sean-mackenzie/billie-bot-claude/billiebot_ws/src/billiebot_sensor_tests/firmware/README.md

The Sensor Nano firmware (sensor_nano.ino) and documentation has been moved to: billie-bot-claude/firmware/sensor_nano
