sean-mackenzie/billie-bot-claude/docs/md/BRINGUP_LADDER_ANALYSIS.md

# BillieBot Bringup Ladder — Systems Decomposition & Analysis

**Author role:** Senior Systems Engineer decomposition
**Sources:** `docs/VERIFICATION.md`, all launch files, node sources, configuration files, interface definitions, and `BillieBot_System_Design.md` (source document of `BillieBot_System_Design.md.pdf`).
**Originally written:** 2026-07-03 (by static analysis only — no code was executed to produce the first revision)
**Last reviewed:** 2026-07-28

> **This is a living document, not a historical snapshot.** Appendix B is the register of record for
> bringup-ladder defects; entries are struck through and marked resolved as they close, and the
> per-rung sections are corrected alongside them so no section describes behavior the code no longer
> has. When you close an item here, also update `DISCREPANCY_RESOLUTION_PLAN.md` (§2 table + sheet)
> and `MBSE_SYSTEM_DECOMPOSITION.md` (§5.4 register) in the same PR.

### Revision log

| Date | Change |
|---|---|
| 2026-07-03 | Initial decomposition of rungs 01–14; Appendix B raised B-1…B-20 |
| 2026-07-17 | B-3, B-4, B-8 resolved (GAP-5, GAP-6, GAP-4) |
| 2026-07-28 | B-9 resolved (GAP-20, lidar by-id path) |
| 2026-07-28 | B-1, B-2 resolved (GAP-16 — `mock_scan` node) and B-13 resolved (tf2 registration import); B-6 resolved (GAP-21 — documented bundled map). Rung 01/05/06/14 sections corrected to match; verified by running the mock ladder rather than by re-reading source |

---

## 1. Purpose & Method

This report decomposes each of the 14 rungs of the Bringup Ladder defined in `docs/VERIFICATION.md`. For each rung it answers:

1. **Referenced files** — launch files (including transitive includes), configs, node sources, verify scripts, and external package dependencies.
2. **Key input parameters** — the parameters that materially determine behavior, with values and rationale.
3. **Runtime process architecture** — which nodes run, what each publishes/subscribes/serves, message types, publish rates, TF contributions, and mock-vs-real differences.
4. **Measurable outputs** — the concrete data and physical observables that verify correct function, with the exact commands to measure them.
5. **Requirements traceability** — which `SYS-*` requirements from the System Design Document the rung satisfies (fully, partially, or could with additions), cross-referenced to the TC-01…TC-22 acceptance-test IDs.

Method: every claim below is traced to a file in this repository. Facts that come from hardware datasheets or upstream package behavior rather than this repo (e.g., RPLidar A1 scan rate, Nav2 default action names) are marked *(inference)*.

### 1.1 System context

BillieBot is a differential-drive indoor robot whose MVP mission is **observe-and-report**: patrol an apartment, find a miniature dachshund (Billie), hold a ≥1.0 m standoff, fuse visual/thermal/audio evidence into a behavioral state, log state transitions to SQLite, and serve a daily HTTP report. The software is a ROS 2 (Humble-targeted) stack split across three processors:

| Host | Role | Nodes (per design §5.2 and the `jetson.launch.py`/`pi.launch.py` split) |
|---|---|---|
| **Jetson Orin Nano** | Real-time autonomy | `rplidar_node`, `base_bridge`, `ekf_filter_node`, `slam_toolbox`/`amcl`, Nav2 stack, `oakd_dog_detector`, `dog_locator`, mission nodes |
| **Raspberry Pi 5** | Sensing & cognition | `thermal_node`, `noir_cam_node`, `audio_classifier`, `speaker_node`, `state_fusion`, `dog_logger`, `daily_report`, `report_server` |
| **Arduino Nano** | Hard real-time I/O | Encoder counting, PID @30 Hz, L298N PWM, battery ADC, 500 ms serial-heartbeat motor cutoff (`firmware/README.md`) |

Multi-machine DDS uses CycloneDDS with multicast disabled and static unicast peers (`billiebot_bringup/config/cyclonedds.xml`: Jetson `192.168.42.100`, Pi `192.168.42.101`). The `jetson.launch.py` and `pi.launch.py` files set `CYCLONEDDS_URI` to this config and launch the host-appropriate subset of rungs — they are deployment groupings, not rungs themselves.

Every rung (except 08 and 12) accepts a `mock:=true` launch argument that substitutes hardware drivers with synthetic publishers so the entire ladder can be exercised on a development machine.

### 1.2 Launch inclusion graph

Rungs compose **transitively** — launching rung N brings up (most of) the rungs below it. Several integration defects identified in Appendix B arise directly from double-inclusion in this graph.

```
14_full_bringup ─┬─► 06_nav2 ─┬─► 05_amcl ─┬─► 01_lidar                (rplidar OR mock_scan)
                 │            │            ├─► 03_ekf ──► 02_base ─┬─► description.launch.py (robot_state_publisher)
                 │            │            │        │              └─► base.launch.py (base_bridge)
                 │            │            │        └─► ekf_node (robot_localization)
                 │            │            └─► localization.launch.py (map_server + amcl + lifecycle_mgr)
                 │            └─► navigation.launch.py (controller + planner
                 │                                       + behaviors + bt_navigator + lifecycle_mgr)
                 ├─► 07_oakd            (oakd_dog_detector)
                 ├─► 08_dog_locator     (dog_locator)
                 ├─► 09_thermal         (thermal_node)
                 ├─► 10_noir            (noir_cam_node)
                 ├─► 11_audio ──► audio.launch.py (audio_classifier + speaker_node)
                 ├─► 12_cognition ──► cognition.launch.py (state_fusion + dog_logger
                 │                                          + daily_report + report_server)
                 └─► 13_mission ──► mission.launch.py (mission_controller + approach_dog_server
                                                        + retreat_server + speak_server
                                                        + dispense_treat_server)

04_slam ─┬─► 01_lidar
         ├─► 03_ekf ──► 02_base ──► (as above)
         └─► slam.launch.py (async_slam_toolbox_node)      [04 is NOT included by 05/06/14 —
                                                             mapping and localization are alternatives]
```

Two duplications that this graph used to expose are now closed: in mock mode `01_lidar` once launched a **second `base_bridge` instance** (named `mock_lidar_stub`) alongside the `03→02` chain — resolved 2026-07-28 (GAP-16), the mock branch now launches the dedicated `mock_scan` node — and rung 06 once started two `ekf_filter_node`s via `navigation.launch.py` — resolved 2026-07-17 (GAP-6). See Appendix B.

### 1.3 Per-rung template

Each rung section below follows the five-question structure: **(1) Referenced files → (2) Key parameters → (3) Runtime architecture → (4) Measurable outputs → (5) Requirements traceability.** All paths are relative to `billiebot_ws/src/` unless otherwise noted.

---

## 2. Rung 01 — Lidar

```bash
ros2 launch billiebot_bringup 01_lidar.launch.py mock:=true
```

### 2.1 Referenced files

| File | Role |
|---|---|
| `billiebot_bringup/launch/01_lidar.launch.py` | Rung entry point; selects real vs. mock via `IfCondition`/`UnlessCondition` |
| `billiebot_base/billiebot_base/mock_scan.py` | **Mock branch only** — synthetic `/scan` publisher (see §2.3) |
| `billiebot_bringup/config/lidar.yaml` | **Real branch only** — serial by-id path, baud, scan mode (GAP-20) |
| `billiebot_bringup/scripts/verify_rung_01.sh` | Verification script (topic existence + `ros2 topic hz`) |
| External: `rplidar_ros` package (`rplidar_node`) | Real lidar driver *(external dependency)* |

### 2.2 Key input parameters

| Parameter | Value | Significance |
|---|---|---|
| `mock` (launch arg) | default `false` | Selects driver vs. placeholder stub |
| `serial_port` | `/dev/serial/by-id/usb-Silicon_Labs_CP2102_..._0001-if00-port0` | RPLidar A1 USB-UART device on the Jetson. Stable by-id path, matching the `base_bridge` convention — plug-in order and `ttyUSBn` numbering are irrelevant (Appendix B-9, GAP-20). Set in `billiebot_bringup/config/lidar.yaml`, not inline in the launch file |
| `serial_baudrate` | `115200` | A1 standard baud |
| `frame_id` | `laser_frame` | Must match the link created by `billiebot_description/urdf/lidar.xacro` (it does) |
| `angle_compensate` | `true` | Interpolates to uniform angular spacing for SLAM |
| `scan_mode` | `Standard` | A1 standard mode: ~8 kHz sample rate, ~5.5 Hz rotation *(datasheet inference)* |

### 2.3 Runtime process architecture

**Real mode** — one node:

| Node | Pub | Type | Rate |
|---|---|---|---|
| `rplidar_node` | `/scan` | `sensor_msgs/LaserScan` | ~5.5–8 Hz *(A1 hardware inference)* |

No TF is produced by this rung. `/scan` messages carry `frame_id: laser_frame`, which is **unresolvable** until rung 02 brings up `robot_state_publisher` (the `chassis → laser_frame` static transform lives in the URDF). Standalone RViz viewing requires setting the fixed frame to `laser_frame`.

**Mock mode** — one node, a purpose-built synthetic lidar (**resolved 2026-07-28, GAP-16**; this rung was previously the ladder's most significant defect):

The mock branch launches `billiebot_base`'s `mock_scan` executable, which publishes a synthetic `LaserScan` describing a rectangular room (`NUM_SAMPLES = 360`, `ROOM_HALF_X = 2.5 m`, `ROOM_HALF_Y = 2.0 m`, with per-beam noise). It replaced a `base_bridge` instance named `mock_lidar_stub` that published no `/scan` at all — the origin of Appendix B-1 and B-2.

| Node | Pub | Type | Rate |
|---|---|---|---|
| `mock_scan` | `/scan` | `sensor_msgs/LaserScan` | 10 Hz, `frame_id: laser_frame` |

Consequences of the fix: the rung's own verify criterion passes in mock, higher rungs no longer gain a duplicate `base_bridge`, and mock SLAM/AMCL/costmaps receive real scan data. Measured 2026-07-28 in the `billiebot-dev` container: `/scan` at **10.008 Hz**, `verify_rung_01.sh` **`[PASS]` ×2**, `ros2 node list` shows `/mock_scan` alone.

### 2.4 Measurable outputs

| Output | Measurement | Expected (real) | Expected (mock) |
|---|---|---|---|
| `/scan` exists & publishes | `ros2 topic echo /scan --once`; `ros2 topic hz /scan` | LaserScan at ~5.5–8 Hz, 360° ranges 0.15–12 m | LaserScan at 10 Hz (observed 10.008 Hz) |
| Scan geometry sane | RViz LaserScan display, fixed frame `laser_frame` | Room outline visible; motor audibly spinning (physical) | Synthetic 5.0 × 4.0 m rectangle |
| Script result | `./scripts/verify_rung_01.sh` | `[PASS]` ×2, exit 0 | `[PASS]` ×2, exit 0 |

The verify script checks topic existence via `ros2 topic info` and then rate via `timeout 5 ros2 topic hz` — it validates *liveness*, not scan content or field ranges.

### 2.5 Requirements traceability

| Requirement | Relationship |
|---|---|
| **SYS-NAV-1** (lidar SLAM map) | **Prerequisite.** `/scan` is the sole input to `slam_toolbox` (rung 04) and AMCL (rung 05). Rung 01 alone doesn't satisfy it, but SYS-NAV-1 is unreachable without it. |
| **SYS-NAV-2, SYS-NAV-3** | Prerequisite — `/scan` drives AMCL localization and both Nav2 costmap obstacle layers (`nav2_params.yaml` `observation_sources: scan`). |
| Design §3.4 BDD-03 | The lidar is modeled under the Perception Subsystem with data allocated to Nav — rung 01 verifies the physical `lidar → jet` USB/UART item flow of IBD-01. |
| TC coverage | No dedicated TC; TC-02…TC-06 begin at rung 02. Now satisfies a lidar-liveness test in mock as well as real, since `mock_scan` publishes a genuine `/scan` (Appendix B-1, resolved) — the proposed TC-23 can be scripted against either mode. |

---

## 3. Rung 02 — Base + Description

```bash
ros2 launch billiebot_bringup 02_base.launch.py mock:=true
```

### 3.1 Referenced files

| File | Role |
|---|---|
| `billiebot_bringup/launch/02_base.launch.py` | Rung entry; includes the two package launches below |
| `billiebot_description/launch/description.launch.py` | Runs `xacro` on the URDF and starts `robot_state_publisher` |
| `billiebot_description/urdf/billiebot.urdf.xacro` | Top-level robot model; includes `robot_core.xacro`, `lidar.xacro`, `oakd_lite.xacro`, `noir_camera.xacro`, `thermal.xacro`, `mic_array.xacro`, `imu.xacro`, `inertial_macros.xacro` |
| `billiebot_base/launch/base.launch.py` | Starts `base_bridge` with the config below |
| `billiebot_base/config/base_driver.yaml` | All drive/serial/battery parameters |
| `billiebot_base/billiebot_base/base_bridge.py` | Differential-drive bridge node (480 lines; contains `MockSerial`) |
| `billiebot_interfaces/srv/EStop.srv` | E-stop service definition |
| `billiebot_bringup/scripts/verify_rung_02.sh` | Verification script |
| `docs/MEASURE_ME.md` | Documents which of these parameters are placeholders pending physical measurement |
| Related (not launched): `reference_my_bot/diff-drive-motor-controller/` and `firmware/README.md` | The Arduino-side serial protocol implementation and the 500 ms watchdog change |

### 3.2 Key input parameters

From `base_driver.yaml` (calibration status per `docs/MEASURE_ME.md`):

| Parameter | Value | Significance |
|---|---|---|
| `port` / `baudrate` | `/dev/serial/by-id/usb-1a86_USB_Serial-if00-port0` @ 57600 | Stable-path Arduino serial link (CH340 adapter) |
| `wheel_radius` | 0.034 m | Odometry scale — **to be measured under load** |
| `wheel_separation` | 0.298 m | Yaw-rate scale — **to be measured** |
| `encoder_ticks_per_rev` | 2000.0 | Tick→radian conversion; reference project offers 1974.7/1779.0 alternatives — **calibrate by driving 1 m** |
| `pid_rate_hz` | 30.0 | Must match Arduino PID loop rate; used in the counts-per-loop conversion |
| `cmd_timeout_sec` | 0.5 | Software deadman: zero motor command if no `/cmd_vel` for 0.5 s (complements the Arduino 500 ms heartbeat cutoff) |
| `publish_rate_hz` | 30.0 | Rate of the odom/joint/TF pipeline |
| `publish_tf` | `false` | EKF owns `odom → base_link` from rung 03 up (GAP-5 resolved 2026-07-17); rung-02-only bench work can restore the base broadcast with the `publish_tf:=true` launch arg (Appendix B-3) |
| `use_imu` | `false` | BNO055 disabled until the A4/A5 encoder rewire (`docs/MEASURE_ME.md`) |
| `battery_divider_ratio` / `battery_pin` | 6.0 / A0 | ADC→voltage: `V = adc·5/1023·6.0` |
| `battery_low_voltage` / `battery_critical_voltage` | 10.5 V / 9.9 V | 3.5 and 3.3 V/cell thresholds (SYS-PLT-2 boundary values) |
| `left/right_motor_sign`, `*_encoder_sign` | 1.0 | Polarity flips set during physical commissioning |
| Description args | `use_lidar/oakd/noir/thermal/mic:=true`, `use_imu:=false` | Gate which sensor links appear in the URDF/TF tree |

### 3.3 Runtime process architecture

Two nodes:

**`robot_state_publisher`** — runs `xacro billiebot.urdf.xacro` at launch time via a `Command` substitution:

| Interface | Direction | Type | Rate |
|---|---|---|---|
| `/robot_description` | pub (latched/transient-local) | `std_msgs/String` | once |
| `/tf_static` | pub | `tf2_msgs/TFMessage` | once — all fixed joints: `base_link→chassis`, `chassis→laser_frame`, `chassis→oakd_link→oakd_link_optical`, `chassis→noir_link→noir_link_optical`, `chassis→thermal_link→thermal_link_optical`, `chassis→mic_array` (names from the xacro files; positions are `TODO(measure)` placeholders) |
| `/joint_states` | sub | `sensor_msgs/JointState` | consumes base_bridge output to publish wheel-joint TF on `/tf` at 30 Hz |

**`base_bridge`** — the drive interface. Internal loop (`update()` on a 30 Hz timer): apply e-stop/timeout gating → send `m <left_cpl> <right_cpl>` motor command over serial → read encoders with `e` → integrate differential-drive odometry (exact midpoint-arc model) → publish. Conversion: `counts_per_loop = rad_s/(2π) · 2000 / 30`.

| Interface | Direction | Type | Rate / trigger |
|---|---|---|---|
| `/cmd_vel` | sub | `geometry_msgs/Twist` | inverse kinematics: `v ± ω·d/2 / r` → wheel targets; ignored while e-stopped |
| `/odom` | pub | `nav_msgs/Odometry` (`odom`→`base_link`, pose + twist) | 30 Hz |
| `/joint_states` | pub | `sensor_msgs/JointState` (`left_wheel_joint`, `right_wheel_joint` pos+vel) | 30 Hz |
| `/battery_state` | pub | `sensor_msgs/BatteryState` (voltage, per-cell array, health enum vs. 10.5/9.9 V thresholds) | 1 Hz |
| TF `odom → base_link` | broadcast | `TransformStamped` | 30 Hz (gated by `publish_tf`) |
| `/e_stop` | service server | `billiebot_interfaces/srv/EStop` (`engage: bool → success, message`) | engage: zeroes targets, sends `m 0 0`, blocks `/cmd_vel`; release: re-enables |

**Serial protocol** (Jetson ↔ Arduino, 57600 baud, `\r`-terminated — mirrors `reference_my_bot` ROSArduinoBridge):

| Cmd | Meaning | Response |
|---|---|---|
| `m L R` | Target wheel speeds in encoder counts/PID-loop | `OK` |
| `e` | Read cumulative encoder ticks | `<left> <right>` |
| `r` | Reset encoders | `OK` |
| `a <pin>` | Read ADC (battery divider) | `0–1023` |

**Mock vs. real:** `MockSerial` replaces `pyserial` in-process. It integrates commanded counts-per-loop into fake encoder ticks (perfect compliance — commanded velocity is instantly achieved) and answers `a` with a constant ADC of 429 → **12.58 V** battery forever. Consequence: battery-triggered SAFE-mode logic (rung 13) can never fire in mock mode.

TF tree after this rung (matches VERIFICATION.md): `odom → base_link → chassis → {laser_frame, oakd_link[_optical], noir_link[_optical], thermal_link[_optical], mic_array}` plus wheel joints.

### 3.4 Measurable outputs

| Output | Measurement | Expected |
|---|---|---|
| Odometry | `ros2 topic hz /odom` → 30 Hz; `ros2 topic echo /odom` | Pose integrates when commanded; twist echoes commanded velocity (mock: exactly) |
| Joint states | `ros2 topic hz /joint_states` → 30 Hz | Wheel positions monotonically increase while driving |
| Battery | `ros2 topic echo /battery_state` | Mock: 12.58 V, health `GOOD`; real: pack voltage within 9.9–12.6 V |
| TF | `ros2 run tf2_tools view_frames` | Single connected tree `odom→base_link→chassis→sensors` |
| Robot description | `ros2 topic echo /robot_description --once` | Valid URDF XML (TC-02) |
| E-stop | `ros2 service call /e_stop billiebot_interfaces/srv/EStop "{engage: true}"` | `success: true`; subsequent `/cmd_vel` produces zero motion / zero odom delta |
| **Physical (real)** | `ros2 topic pub /cmd_vel geometry_msgs/msg/Twist "{linear: {x: 0.1}}"` | Robot drives forward ~0.1 m/s (wrong direction ⇒ flip `*_sign` params per MEASURE_ME); odom `x` grows ≈ tape-measure distance |
| Closed-loop odometry sanity | Drive 1.0 m, compare `/odom` | Error budget informs `encoder_ticks_per_rev` calibration |
| Script | `./scripts/verify_rung_02.sh` | 6/6 PASS (4 topics + `/tf` + `/e_stop`), exit 0 |

### 3.5 Requirements traceability

| Requirement / TC | Relationship |
|---|---|
| **TC-02** (URDF validity → SYS-NAV-1) | **Satisfied** — `/robot_description` published from the xacro chain |
| **TC-03** (Odometry → SYS-NAV-2) | **Satisfied (mechanism)** — `/odom` at 30 Hz. The ≤0.15 m accuracy figure of SYS-NAV-2 belongs to rung 05 + a physical test |
| **TC-04** (Joint states) | **Satisfied** |
| **TC-05** (Battery monitoring → SYS-PLT-2) | **Partial** — voltage measurement, per-cell reporting, and threshold-based health enums exist. The *reaction* (enter SAFE, stop, alert) lives in rung 13's mission controller; "request pickup"/alert is unimplemented |
| **TC-06** (E-stop service → SYS-PLT-5) | **Partial** — the software e-stop path exists and stops motor commands. The **200 ms PWM-cut latency** and the **Arduino-side 500 ms heartbeat watchdog** are firmware properties (`firmware/README.md`, `AUTO_STOP_INTERVAL 500`) verifiable only on hardware with a timing rig — not by this rung's script |
| **SYS-PLT-4** (teleop) | **Enabler** — `/cmd_vel` + `/e_stop` are exactly the teleop surface; no teleop node is launched by any rung |
| **SYS-EXT-4 note** | `base_bridge` odometry feeds the EKF that the future engagement-outcome measurement ("dog approaches robot") will rely on |

---

## 4. Rung 03 — EKF

```bash
ros2 launch billiebot_bringup 03_ekf.launch.py mock:=true
```

### 4.1 Referenced files

| File | Role |
|---|---|
| `billiebot_bringup/launch/03_ekf.launch.py` | Rung entry; includes **rung 02 in its entirety**, then adds the EKF |
| `billiebot_navigation/config/ekf.yaml` | `robot_localization` configuration |
| All rung-02 files | Transitively included |
| External: `robot_localization` (`ekf_node`) | The filter implementation *(external dependency)* |

Note the rung's docstring says "EKF on top of base **+ lidar**", but the launch file includes only `02_base.launch.py` — no lidar. Correct behavior (the EKF doesn't consume `/scan`), stale comment.

### 4.2 Key input parameters

From `ekf.yaml`:

| Parameter | Value | Significance |
|---|---|---|
| `frequency` | 30.0 | Filter output rate, matched to base_bridge's 30 Hz input |
| `two_d_mode` | `true` | Planar robot: z/roll/pitch forced to zero |
| `publish_tf` | `true` | EKF broadcasts `odom → base_link` — sole owner since GAP-5 resolution (base_bridge default is now `false`; Appendix B-3) |
| `odom_frame`/`base_link_frame`/`world_frame` | `odom`/`base_link`/`odom` | Odom-frame filter (map frame left to SLAM/AMCL) |
| `odom0` | `/odom` | Sole active sensor input |
| `odom0_config` | fuses x, y, yaw, vx, vy, vyaw | Absolute pose + planar velocities from wheel odometry |
| `imu0` (commented out) | `/imu/data` | Entire IMU block disabled pending the BNO055 A4/A5 rewire — with a single sensor the "fusion" is effectively a smoother, not a multi-sensor EKF |
| `process_noise_covariance` | 15×15 diag | Standard robot_localization defaults, lightly tuned |

### 4.3 Runtime process architecture

Everything from rung 02, plus:

| Node | Interface | Direction | Type | Rate |
|---|---|---|---|---|
| `ekf_filter_node` | `/odom` | sub | `nav_msgs/Odometry` | 30 Hz in |
| | `/odometry/filtered` | pub | `nav_msgs/Odometry` | 30 Hz |
| | TF `odom → base_link` | broadcast | | 30 Hz |
| | `/set_pose` | sub | `PoseWithCovarianceStamped` | manual filter reset *(robot_localization standard interface — inference)* |
| | `/diagnostics` | pub | `diagnostic_msgs/DiagnosticArray` | periodic *(standard — inference)* |

**Data flow:** `base_bridge /odom → ekf_filter_node → /odometry/filtered`. Nav2 consumes `/odometry/filtered` as design §5.2 intends — `nav2_params.yaml` sets `odom_topic: /odometry/filtered` for both `bt_navigator` and `controller_server` (B-8 resolved 2026-07-17, GAP-4).

**TF ownership (GAP-5 resolved 2026-07-17):** the EKF is the sole `odom → base_link` broadcaster from this rung up — `base_driver.yaml` now defaults `publish_tf: false`, and base_bridge only re-enables it via the explicit `publish_tf:=true` launch arg for rung-02-only bench work. (Historically both broadcast at 30 Hz; mock agreement masked the defect, while on hardware the EKF-smoothed pose would diverge from raw integration and TF consumers would see time-interleaved jumps.)

### 4.4 Measurable outputs

| Output | Measurement | Expected |
|---|---|---|
| Filtered odometry | `ros2 topic hz /odometry/filtered` → ~30 Hz; `echo` | Pose tracks `/odom`; covariance populated (unlike `/odom`, which leaves covariance zero) |
| TF health | `ros2 run tf2_ros tf2_echo odom base_link` | Continuous transform; **watch for dual-publisher jitter** |
| Node liveness | `ros2 node list` | `ekf_filter_node` present exactly once (twice indicates rung 06's duplicate) |
| Script | `./scripts/verify_rung_03.sh` | `[PASS] /odometry/filtered exists`, exit 0 (existence only — does not verify rate or content) |

### 4.5 Requirements traceability

| Requirement | Relationship |
|---|---|
| **SYS-NAV-2** (≤0.15 m localization) | **Supporting mechanism** — the EKF provides the smoothed odom-frame state that AMCL corrects into the map frame. With the IMU disabled its contribution over raw odometry is modest; enabling `imu0` after the hardware rewire is the intended upgrade path (design §5.1: "wheel odom ⊕ BNO055") |
| **SYS-NAV-3/4** | Supporting — Nav2 controller behavior depends on odometry quality |
| Design §5.2 row `ekf_localization` | Verifies the designed node exists with the designed I/O (`/odom` in, `/odometry/filtered` + TF out); the designed `/imu/data` input is dormant |
| TC coverage | No dedicated TC; rung 03 is infrastructure for TC-16/TC-19 class tests |

---

## 5. Rung 04 — SLAM

```bash
ros2 launch billiebot_bringup 04_slam.launch.py mock:=true
```

### 5.1 Referenced files

| File | Role |
|---|---|
| `billiebot_bringup/launch/04_slam.launch.py` | Rung entry; includes `01_lidar` + `03_ekf` (which includes 02) + `slam.launch.py` |
| `billiebot_navigation/launch/slam.launch.py` | Starts `slam_toolbox` `async_slam_toolbox_node` |
| `billiebot_navigation/config/slam_toolbox_params.yaml` | Full mapper configuration (Ceres solver, loop closure, scan matching) |
| All rung 01/02/03 files | Transitively included |
| External: `slam_toolbox` *(external dependency)* | |

### 5.2 Key input parameters

From `slam_toolbox_params.yaml`:

| Parameter | Value | Significance |
|---|---|---|
| `mode` | `mapping` | Online map building (vs. localization mode) |
| `scan_topic` | `/scan` | Ties directly to rung 01's output |
| `odom_frame`/`map_frame`/`base_frame` | `odom`/`map`/`base_link` | Standard REP-105 chain |
| `resolution` | 0.05 m | Occupancy-grid cell size |
| `max_laser_range` | 12.0 m | Matches RPLidar A1 envelope |
| `map_update_interval` | 5.0 s | `/map` republish cadence |
| `minimum_travel_distance` / `_heading` | 0.5 m / 0.5 rad | New scan-node admission gates — robot must move for the map to grow |
| `transform_publish_period` | 0.02 s | `map → odom` TF at 50 Hz |
| `do_loop_closing` | `true` | With `loop_search_maximum_distance: 3.0`, apartment-scale loop closure |
| `solver_plugin` | `CeresSolver` (SPARSE_NORMAL_CHOLESKY / LM) | Pose-graph backend |

Launch args: `mock` (propagated to 01 and 03), `use_sim_time` (default false).

### 5.3 Runtime process architecture

Everything from rungs 01+02+03, plus:

| Node | Interface | Direction | Type | Rate |
|---|---|---|---|---|
| `slam_toolbox` | `/scan` | sub | `LaserScan` | ~5.5 Hz in (real) |
| | TF `odom → base_link` | consume | | needs a valid odom chain |
| | `/map` | pub | `nav_msgs/OccupancyGrid` | every 5 s (`map_update_interval`) |
| | `/map_metadata` | pub | `nav_msgs/MapMetaData` | with map |
| | TF `map → odom` | broadcast | | 50 Hz |
| | `/slam_toolbox/save_map`, `/slam_toolbox/serialize_map` etc. | services | `slam_toolbox` srvs | on demand *(standard slam_toolbox interface — inference)* |

**Composition in mock (both former caveats resolved 2026-07-28, GAP-16):**
1. `/scan` is published by `mock_scan`, so `slam_toolbox` scan-matches and **does** produce a `/map` in mock. Observed 2026-07-28 in the `billiebot-dev` container: `/map` present at 101 × 81 cells @ 0.05 m/cell, `/scan` at 9.991 Hz. The map is of the synthetic rectangle, so it exercises the plumbing — it is not a map of anywhere real.
2. `04 → 01(mock)` now launches `mock_scan` rather than a second `base_bridge`, so exactly one `base_bridge` runs (from `04 → 03 → 02`). Verified: `ros2 node list | grep -c base_bridge` → **1**. With GAP-5/GAP-6 also closed, the EKF is the single `odom → base_link` broadcaster.

**Real-mode data flow:** teleoperate the robot (operator publishes `/cmd_vel`, per Build Phase 2 of the design) → wheel odometry + EKF hold the `odom` frame → `slam_toolbox` scan-matches `/scan` against the growing pose graph → publishes `/map` and the `map → odom` correction.

### 5.4 Measurable outputs

| Output | Measurement | Expected |
|---|---|---|
| Map | `ros2 topic echo /map --once` (header + info); RViz Map display | Occupancy grid appears and **grows as the robot is driven**; walls crisp after loop closure (physical+data) |
| TF chain complete | `ros2 run tf2_tools view_frames` | `map → odom → base_link → …` one connected tree |
| Map persistence (SYS-NAV-1 "persist") | `ros2 run nav2_map_server map_saver_cli -f apartment` or `/slam_toolbox/save_map` | `apartment.yaml` + `.pgm` on disk — this artifact is the **input to rungs 05/06** |
| Pose-graph health | slam_toolbox console output | Scan-match responses above `link_match_minimum_response_fine: 0.1` |
| Mock ceiling | `ros2 node list` | Nodes alive, but no `/map` — expected failure mode |

### 5.5 Requirements traceability

| Requirement | Relationship |
|---|---|
| **SYS-NAV-1** ("build and persist a 2-D occupancy map using onboard lidar SLAM", Verify: **D**) | **Directly satisfied by demonstration** on real hardware — this is *the* rung for SYS-NAV-1. The Build Plan Phase 2 exit criterion ("Map complete") is this rung's acceptance |
| **SYS-NAV-2** | Enabler — produces the saved map AMCL localizes against |
| **SYS-NAV-6 / SYS-FND-1** | Enabler — patrol waypoints (`patrol_waypoints.yaml`) and room boundaries (`rooms.yaml`) are defined in the map frame this rung creates; both configs carry "update after mapping" notes |
| TC coverage | Feeds TC-16 (waypoint navigation) indirectly; no dedicated mapping TC exists — **gap**: consider a TC that asserts a saved map file with >N known-free cells |

---

## 6. Rung 05 — AMCL Localization

```bash
ros2 launch billiebot_bringup 05_amcl.launch.py mock:=true \
  map:="$(ros2 pkg prefix billiebot_navigation)/share/billiebot_navigation/maps/my_apartment_v1.yaml"
```

(VERIFICATION.md now shows this rung with both arguments. `map:=` is required in either mode — see Appendix B-6 / GAP-21; `mock:=true` is what lets the rung run without the real lidar and Arduino.)

### 6.1 Referenced files

| File | Role |
|---|---|
| `billiebot_bringup/launch/05_amcl.launch.py` | Rung entry; includes `01_lidar` + `03_ekf`(→02) + `localization.launch.py`, forwarding `map` |
| `billiebot_navigation/launch/localization.launch.py` | `nav2_map_server` + `nav2_amcl` + `nav2_lifecycle_manager` |
| `billiebot_navigation/config/amcl_params.yaml` | Particle filter configuration |
| `billiebot_navigation/config/nav2_params.yaml` | Only its `map_server:` section is consumed here |
| User-supplied `map.yaml` + `.pgm` | The rung-04 artifact |
| External: `nav2_map_server`, `nav2_amcl`, `nav2_lifecycle_manager` *(external)* | |

### 6.2 Key input parameters

| Parameter | Value | Significance |
|---|---|---|
| `map` (launch arg) | default `''` | **Required — the empty default is deliberate** (the map is a deployment choice, not something the launch file should pick). With it unset, `map_server` has no `yaml_filename`, its lifecycle *configure* fails, and the lifecycle manager never reaches *active* — the rung silently does nothing useful. The repo ships `billiebot_navigation/maps/my_apartment_v1.yaml` for this purpose and the guides now pass it explicitly (Appendix B-6, resolved 2026-07-28 / GAP-21) |
| `min_particles` / `max_particles` | 500 / 2000 | Filter size, apartment-appropriate |
| `laser_model_type` | `likelihood_field` | Standard indoor model; `max_beams: 60` subsampling |
| `laser_min_range` / `laser_max_range` | 0.15 / 12.0 m | Matches A1 |
| `update_min_d` / `update_min_a` | 0.25 m / 0.2 rad | Motion gates for filter updates — the robot must move to converge |
| `alpha1–alpha5` | 0.2 | `DifferentialMotionModel` odometry noise |
| `transform_tolerance` | 1.0 s | Future-dating of the `map→odom` TF |
| `set_initial_pose` / `initial_pose` | `true` / (0,0,0,0) | Auto-initializes at the map origin — correct only if the robot physically starts at the mapping start point (`map_start_at_dock: true` in rung 04 makes this consistent) |
| `tf_broadcast` | `true` | AMCL owns `map → odom` |

### 6.3 Runtime process architecture

Everything from rungs 01+02+03 (real lidar assumed), plus three lifecycle-managed nodes:

| Node | Interface | Direction | Type | Rate |
|---|---|---|---|---|
| `map_server` | `/map` | pub (transient-local) | `nav_msgs/OccupancyGrid` | latched once |
| `amcl` | `/scan` | sub | `LaserScan` | ~5.5 Hz in |
| | `/initialpose` | sub | `PoseWithCovarianceStamped` | operator relocalization (RViz "2D Pose Estimate") |
| | `/particle_cloud` | pub | `nav2_msgs/ParticleCloud` | on filter update (motion-gated) |
| | `/amcl_pose` | pub | `PoseWithCovarianceStamped` | on update; `save_pose_rate: 0.5` |
| | TF `map → odom` | broadcast | | per update, future-dated 1.0 s |
| `lifecycle_manager_localization` | `autostart: true`, manages `[map_server, amcl]` | | | bond/heartbeat |

**Full TF chain now:** `map →(amcl) odom →(base_bridge ∥ EKF, duplicated) base_link →(rsp) chassis → sensors`.

**Mock composition note (updated 2026-07-28):** with `mock:=true`, `mock_scan` supplies `/scan`, so AMCL receives laser data and the duplicate-base_bridge problem is gone (GAP-16). AMCL still cannot *converge* in mock, because the synthetic scan is a 5 × 4 m rectangle while the shipped map is an apartment — the two never match. Mock exercises the lifecycle, TF chain, and topic plumbing; localization accuracy (NAV-05, ≤ 0.15 m) remains a hardware measurement.

### 6.4 Measurable outputs

| Output | Measurement | Expected |
|---|---|---|
| Particle cloud | RViz `ParticleCloud` display; `ros2 topic echo /particle_cloud --once` | Cloud appears at the initial pose; **visibly converges** (shrinks) as the robot drives — the canonical physical+data verification |
| Pose estimate | `ros2 topic echo /amcl_pose` | Covariance decreases with motion; pose matches the robot's true room position |
| `map → odom` TF | `ros2 run tf2_ros tf2_echo map odom` | Present and stable after convergence |
| Lifecycle | `ros2 lifecycle get /map_server /amcl` *(or lifecycle manager log)* | Both `active`; failure here almost always means a bad/missing `map` arg |
| **SYS-NAV-2 quantitative test** | Place robot at ≥3 surveyed points; compare `/amcl_pose` to tape-measured ground truth | Mean position error ≤ 0.15 m |
| Script | none exists for rung 05 (gap) | — |

### 6.5 Requirements traceability

| Requirement | Relationship |
|---|---|
| **SYS-NAV-2** (localize within saved map, ≤0.15 m mean error, Verify: **T**) | **Directly targeted** — this rung *is* the localization mechanism; the quantitative test above completes it. Build Phase 2 exit: "reloc ≤ 0.15 m (TC-NAV-2)" |
| **SYS-NAV-3/5/6, SYS-FND-*** | Prerequisite — every map-frame behavior (Nav2 goals, patrol waypoints, dog map pose, room attribution) depends on this TF |
| **SYS-STL-2** | Enabler — logged event locations (x, y, room) are only meaningful with map-frame localization |
| TC coverage | Supports TC-16; no dedicated relocalization TC in the VERIFICATION.md table — the design's TC-NAV-2 naming suggests one was intended (**traceability gap**) |

---

## 7. Rung 06 — Nav2

```bash
ros2 launch billiebot_bringup 06_nav2.launch.py mock:=true map:=/path/to/map.yaml
```

### 7.1 Referenced files

| File | Role |
|---|---|
| `billiebot_bringup/launch/06_nav2.launch.py` | Rung entry; includes `05_amcl` (full chain) + `navigation.launch.py` |
| `billiebot_navigation/launch/navigation.launch.py` | `controller_server` + `planner_server` + `behavior_server` + `bt_navigator` + `lifecycle_manager_navigation` (Nav2 only — its former second `ekf_node` was removed, GAP-6 resolved 2026-07-17) |
| `billiebot_navigation/config/nav2_params.yaml` | All Nav2 servers + both costmaps |
| `billiebot_bringup/scripts/verify_rung_06.sh` | Verification script |
| All rung 01/02/03/05 files | Transitive |
| External: `nav2_controller`, `nav2_planner`, `nav2_behaviors`, `nav2_bt_navigator`, `nav2_lifecycle_manager`, `dwb_core`, `nav2_navfn_planner`, `nav2_costmap_2d` *(external)* | |

### 7.2 Key input parameters

From `nav2_params.yaml`:

| Group | Parameter | Value | Significance |
|---|---|---|---|
| controller | `controller_frequency` | 20 Hz | `/cmd_vel` output rate while navigating |
| controller | `FollowPath` plugin | `dwb_core::DWBLocalPlanner` | Design §5.1 choice ("DWB or MPPI") |
| DWB | `max_vel_x`, `max_speed_xy` | **0.3 m/s** | **Direct encoding of SYS-NAV-5's normal-transit cap.** The 0.15 m/s near-dog limit has **no implementation** (no speed-filter costmap layer/keepout zone exists — Appendix B-7) |
| DWB | `max_vel_theta` / `acc_lim_x` | 1.0 rad/s / 2.5 m/s² | Kinodynamic envelope |
| progress_checker | `required_movement_radius`, `movement_time_allowance` | 0.5 m / 10 s | **Stuck detection** — looser than SYS-NAV-4's ">5 s no progress" wording (Appendix B-7) |
| goal checker | `xy_goal_tolerance` | 0.25 m | Waypoint arrival radius |
| planner | `GridBased` | `NavfnPlanner`, `tolerance 0.5`, `allow_unknown: true` | Global planner |
| behaviors | `behavior_plugins` | `["spin", "backup", "wait"]` @ `cycle_frequency` 10 Hz | The SYS-NAV-4 recovery primitives (launch file comments this explicitly) |
| bt_navigator | `navigators` | `navigate_to_pose`, `navigate_through_poses` | The action surface consumed by rung 13 and TC-16 |
| bt_navigator, controller_server | `odom_topic` | `/odometry/filtered` | EKF-filtered odometry per design §5.2 (B-8 resolved 2026-07-17, GAP-4; controller_server's param had been silently defaulting to raw odom) |
| local costmap | rolling 3×3 m @ `update` 5 Hz / `publish` 2 Hz, `robot_radius` 0.18 m, inflation 0.55 m | Obstacle layer from `/scan` (marking+clearing, 2.5 m obstacle range) |
| global costmap | full map @ 1 Hz, static + obstacle + inflation layers | Same `/scan` source |

### 7.3 Runtime process architecture

Everything from rung 05, plus six nodes. The action/topic surface:

| Node | Interface | Direction | Type/notes | Rate |
|---|---|---|---|---|
| `controller_server` | `/cmd_vel` | pub | `geometry_msgs/Twist` → consumed by `base_bridge` | 20 Hz while navigating |
| | `follow_path` | action server | `nav2_msgs/action/FollowPath` | |
| | `/local_costmap/costmap` | pub | `OccupancyGrid` | 2 Hz |
| `planner_server` | `compute_path_to_pose` | action server | `nav2_msgs/action/ComputePathToPose`; publishes `/plan` (Path) | on request |
| | `/global_costmap/costmap` | pub | `OccupancyGrid` | 1 Hz |
| `behavior_server` | `spin`, `backup`, `wait` | action servers | `nav2_msgs` actions — recovery primitives | 10 Hz cycle |
| `bt_navigator` | `navigate_to_pose` | **action server** | `nav2_msgs/action/NavigateToPose` — the system's primary mobility API (used by `mission_controller`, `approach_dog_server`, TC-16) | |
| | `navigate_through_poses` | action server | multi-waypoint variant → SYS-NAV-6 | |
| `ekf_filter_node` | single instance, from rung 03 | | the former duplicate launched by `navigation.launch.py` was removed 2026-07-17 (Appendix B-4, GAP-6) | 30 Hz |
| `lifecycle_manager_navigation` | manages the four Nav2 servers | | autostart | |

**Closed control loop now exists:** `navigate_to_pose` goal → bt_navigator ticks its BT → planner (global costmap/map) → controller DWB (local costmap from `/scan`, odometry) → `/cmd_vel` → `base_bridge` → serial `m` commands → wheels → encoders → `/odom` → EKF/AMCL → TF → costmaps. This is the design's IBD-01 "perception→planning loop on one machine" realized.

**Mock ceiling:** no `/scan` → costmap obstacle layers receive nothing; with no map arg the entire localization side is inactive. `verify_rung_06.sh` can still find the *action* (bt_navigator advertises it once active) but costmap topic checks will fail without a map. Effectively, rung 06 is a **real-hardware rung**; mock only proves process/action liveness.

### 7.4 Measurable outputs

| Output | Measurement | Expected |
|---|---|---|
| Action surface | `ros2 action list` | `/navigate_to_pose`, `/navigate_through_poses`, `/follow_path`, `/compute_path_to_pose`, `/spin`, `/backup`, `/wait` |
| Costmaps | `ros2 topic hz /local_costmap/costmap` (~2 Hz), `/global_costmap/costmap` (~1 Hz); RViz costmap displays | Inflated obstacles visible around lidar returns |
| **End-to-end navigation (physical)** | RViz "Nav2 Goal" or `ros2 action send_goal /navigate_to_pose nav2_msgs/action/NavigateToPose "{pose: {header: {frame_id: map}, pose: {position: {x: 1.0}}}}"` | Robot plans (green `/plan` path), drives ≤0.3 m/s, stops within 0.25 m of goal, action returns SUCCEEDED |
| Dynamic obstacle response | Step in front of the moving robot | Local costmap marks; robot replans/stops (SYS-NAV-3 demonstration) |
| Recovery behaviors | Block the robot completely | progress checker trips after ~10 s; spin/backup recoveries execute (SYS-NAV-4 partial demonstration) |
| Speed cap | `ros2 topic echo /cmd_vel` during transit | `linear.x ≤ 0.3` always (TC-18 evidence) |
| Script | `./scripts/verify_rung_06.sh` | 3/3 PASS (action + both costmap topics) |

### 7.5 Requirements traceability

| Requirement | Relationship |
|---|---|
| **SYS-NAV-3** (collision-free paths, replanning around dynamic obstacles incl. the dog, Verify: D) | **Satisfied (mechanism + demonstration)** — planner/controller/costmaps with marking+clearing from `/scan`. Note the dog (0.15–0.25 m tall) *is* within lidar plane visibility only if the lidar height permits; the OAK-D detection path does not feed costmaps (**could**: add a speed/keepout filter fed by `/dog/pose_map`) |
| **SYS-NAV-4** (stuck detection >5 s, recoveries, 3 failures → SAFE + alert, Verify: T) | **Partial** — recovery primitives (spin/backup/wait) and a progress checker exist; the 5 s threshold is configured as 10 s/0.5 m; the "3 failed recoveries → SAFE + alert" escalation is delegated to `mission_controller` whose failure counter is never incremented (Appendix B-5). TC-19 cannot currently pass end-to-end |
| **SYS-NAV-5** (≤0.3 m/s transit; ≤0.15 m/s within 2 m of dog, Verify: T) | **Half-satisfied** — 0.3 cap encoded in DWB; near-dog slowdown unimplemented (design intended "Nav2 speed-restricted zones / speed-filter mask around detected dog") — TC-18 partial |
| **SYS-NAV-6** (configurable patrol route, Verify: D) | **Enabler** — `navigate_through_poses`/waypoint capability exists; `patrol_waypoints.yaml` defines the route, but **no launched node reads that file** (Appendix B-5). TC-16 currently has no automated driver |
| **SYS-FND-3** | Enabler — `approach_dog_server` (rung 13) rides on `navigate_to_pose` |
| Design §5.2 `nav2` row | Matches: subscribes map/scan/odometry, publishes `/cmd_vel`, serves NavigateToPose. Deviation: `FollowWaypoints` named in design vs. `navigate_through_poses` configured here |

---

## 8. Rung 07 — OAK-D Dog Detector

```bash
ros2 launch billiebot_bringup 07_oakd.launch.py mock:=true
```

### 8.1 Referenced files

| File | Role |
|---|---|
| `billiebot_bringup/launch/07_oakd.launch.py` | Rung entry — launches the detector **standalone** (no other rungs) |
| `billiebot_perception/billiebot_perception/oakd_dog_detector.py` | Node source (DepthAI pipeline + mock) |
| `billiebot_interfaces/msg/DogDetection3D.msg` | Output message |
| `billiebot_bringup/scripts/verify_rung_07.sh` | Verification script |
| `billiebot_perception/config/perception.yaml` | **Not loaded by this rung** — the launch passes only `{'mock': mock}`; the node runs on its declared defaults (which happen to equal the yaml values). Only `perception.launch.py` (unused by the ladder) loads the yaml. Same pattern for rungs 09/10 (Appendix B-10) |
| External: `depthai` Python SDK, YOLOv8n `.blob` model *(external)* | |

### 8.2 Key input parameters

| Parameter | Default | Significance |
|---|---|---|
| `mock` | `false` | Synthetic detections vs. DepthAI pipeline |
| `confidence_threshold` | 0.5 | Detection gate (design: "COCO class `dog`, tuned threshold") |
| `model_path` | `''` | Path to the YOLOv8n blob. **Empty default ⇒ in real mode the node now logs an ERROR and exits non-zero (GAP-11, resolved 2026-07-31) rather than idling silently.** `perception.yaml` sets a real deployment path and `07_oakd.launch.py` now loads it (Appendix B-10/B-11) |
| `camera_frame` | `oakd_link_optical` | Stamped into detections; matches `oakd_lite.xacro` |
| `publish_rate_hz` | 5.0 | Poll/publish rate — deliberately matches SYS-PER-1's "≥5 FPS" |

Real-pipeline internals (hard-coded): 416×416 RGB preview from the 1080p color camera; stereo depth from both 400p monos (HIGH_DENSITY preset); `YoloSpatialDetectionNetwork` with depth thresholds 100–5000 mm; COCO label filter `== 16` (dog).

### 8.3 Runtime process architecture

One node, `oakd_dog_detector`:

| Interface | Direction | Type | Rate |
|---|---|---|---|
| `/dog/detections_3d` | pub | `billiebot_interfaces/DogDetection3D` — bbox (px), confidence, `geometry_msgs/Point position` in camera optical frame (m), depth, label | ≤5 Hz (only when a dog is detected) |
| `/dog/found` | pub | `std_msgs/Bool` | 5 Hz continuous (true/false every tick) |

**Mock behavior (5 Hz timer):** each tick, 70 % probability of publishing a detection with confidence ≈0.85±0.1 at position ≈(0.05, −0.10, 2.0±0.3) m (i.e., a dog ~2 m in front of the optical axis) plus `found=true`; otherwise `found=false` only. Expected steady-state: `/dog/detections_3d` ≈3.5 Hz, `/dog/found` = 5 Hz alternating.

**Real behavior:** detections come from the OAK-D's on-device NN (design: "~15–20 FPS on RVC2, zero Jetson GPU load"), drained by the node at 5 Hz. Depth (`spatialCoordinates`, mm→m) gives the 3-D position. Latent defect: `det.xmin/xmax` from DepthAI are **normalized 0–1 floats**; `int(det.xmin)` truncates the bbox fields to 0 (Appendix B-11) — position/depth are unaffected.

No TF is consumed or produced; frame resolution happens downstream in rung 08.

### 8.4 Measurable outputs

| Output | Measurement | Expected |
|---|---|---|
| Detections | `ros2 topic echo /dog/detections_3d` | Mock: bursts at ~3.5 Hz, conf 0.75–0.95, z ≈ 1.7–2.3 m. Real: detections when a dog (or dog photo) is in frame |
| Found flag | `ros2 topic hz /dog/found` → 5 Hz | Boolean duty cycle ≈70 % true in mock |
| Rate vs. SYS-PER-1 | `ros2 topic hz /dog/detections_3d` with a continuously visible dog | ≥5 Hz sustained |
| Depth accuracy (real) | Place target at tape-measured 2.0 m | `position.z` within ±0.2 m (SYS-PER-2 figure) |
| Script | `./scripts/verify_rung_07.sh` | 2/2 topics PASS |

### 8.5 Requirements traceability

| Requirement | Relationship |
|---|---|
| **SYS-PER-1** (dog in RGB ≥5 FPS, ≥85 % recall ≤4 m, Verify: T) | **Mechanism satisfied** — 5 Hz spatial YOLO with confidence gate. The recall figure requires a field test with the actual dog (Build Phase 4 / TC-07); mock mode proves plumbing only |
| **SYS-PER-2** (3-D position ±0.2 m @ 2 m, Verify: T) | **Partial** — camera-frame 3-D position from stereo; map-frame completion is rung 08 |
| **TC-07** (Dog 3D detection → SYS-PER-1/2) | **Satisfied** at topic level by the mock suite |
| Design §5.2 `oakd_dog_detector` row | Matches pubs `/dog/detections_3d`; design also lists `/oak/rgb/preview` which is **not implemented** (no image preview topic — minor deviation, limits SYS-PLT-4 operator visualization of detections) |

---

## 9. Rung 08 — Dog Locator

```bash
ros2 launch billiebot_bringup 08_dog_locator.launch.py
```

(No `mock` argument exists — the node is pure software.)

### 9.1 Referenced files

| File | Role |
|---|---|
| `billiebot_bringup/launch/08_dog_locator.launch.py` | Rung entry — starts `dog_locator` with **no parameters** (code defaults apply) |
| `billiebot_perception/billiebot_perception/dog_locator.py` | Node source |
| `billiebot_interfaces/msg/DogDetection3D.msg` | Input message |
| Upstream dependencies at runtime: rung 07 (detections), rung 02 (URDF static TF for `oakd_link_optical`), rung 04 or 05 (`map → odom` TF) | The rung is only *meaningful* inside a larger stack |

### 9.2 Key input parameters

| Parameter | Default | Significance |
|---|---|---|
| `map_frame` | `map` | Target frame for the transform |
| `min_confidence` | 0.5 | Drops low-confidence detections before transforming |

### 9.3 Runtime process architecture

One node, `dog_locator`, purely event-driven (no timer):

| Interface | Direction | Type | Rate |
|---|---|---|---|
| `/dog/detections_3d` | sub | `DogDetection3D` | ≤5 Hz in |
| TF (`Buffer` + `TransformListener`) | consume | needs `map ← odom ← base_link ← chassis ← oakd_link_optical` complete at the detection timestamp (0.1 s timeout) | |
| `/dog/pose_map` | pub | `geometry_msgs/PoseStamped` (map frame, identity orientation) | one per accepted detection (≤5 Hz) |
| `/dog/found` | pub | `std_msgs/Bool` (always `true` on success) | with each pose |

Processing: detection → confidence gate → wrap `position` as `PointStamped` in the camera optical frame → `tf_buffer.transform(..., map)` → publish pose. On `TransformException` it logs at debug level and stays silent — hence VERIFICATION.md's phrasing "*publishing when detections + TF available*."

Two integration observations:
1. **`/dog/found` has two publishers** once rung 07 and 08 both run (07 publishes true/false at 5 Hz; 08 publishes only `true` on success). Subscribers like `mission_controller` see an interleaved stream (Appendix B-12).
2. **(Resolved)** `Buffer.transform()` on a `PointStamped` requires the type-registration side-effect of importing `tf2_geometry_msgs`. That import was previously absent, so every callback would have raised an unregistered-type error the `except TransformException` clause does not catch. It is now present and annotated at `dog_locator.py:13` (Appendix B-13, resolved). Pose *correctness* through the camera→map chain is still unmeasured — that needs real detections.

### 9.4 Measurable outputs

| Output | Measurement | Expected |
|---|---|---|
| Map-frame pose | `ros2 topic echo /dog/pose_map` | PoseStamped in `map` frame at ≤5 Hz **only when** rungs 02+05(+07) provide TF and detections; RViz Pose display sits on the dog's map location |
| Standalone behavior | launch rung 08 alone | Node starts, logs `DogLocator started`, publishes nothing — correct (no inputs) |
| Accuracy (real) | Compare `/dog/pose_map` to the dog's surveyed position | ±0.2 m at 2 m per SYS-PER-2 |
| Consistency | Drive the robot around a static dog target | `/dog/pose_map` stays fixed in the map frame while the camera-frame detection moves — the definitive TF-correctness test |

### 9.5 Requirements traceability

| Requirement | Relationship |
|---|---|
| **SYS-PER-2** (3-D dog position **in the map frame**, Verify: T) | **Completes the requirement** begun in rung 07 — this rung is the camera→map transform stage. TC-08 ("Dog locator TF") |
| **SYS-FND-1** | Enabler — "last-known location first" seeding requires exactly this map-frame pose |
| **SYS-FND-3** | Enabler — `approach_dog_server` consumes `/dog/pose_map` to compute the standoff goal |
| **SYS-STL-1/2** | Enabler — `state_fusion` takes `/dog/pose_map` for position/room attribution; `dog_logger` writes x/y/room from it |
| Design §5.2 `dog_locator` row | Matches exactly (subs `/dog/detections_3d` + TF; pubs `/dog/pose_map`, `/dog/found`) |

---

## 10. Rung 09 — Thermal Camera

```bash
ros2 launch billiebot_bringup 09_thermal.launch.py mock:=true
```

### 10.1 Referenced files

| File | Role |
|---|---|
| `billiebot_bringup/launch/09_thermal.launch.py` | Rung entry — `thermal_node` standalone, only `mock` passed (defaults = `perception.yaml` values; yaml itself not loaded, Appendix B-10) |
| `billiebot_perception/billiebot_perception/thermal_node.py` | Node source (MLX90640 driver + blob detector + mock) |
| `billiebot_interfaces/msg/ThermalBlob.msg` | Output message |
| External: `adafruit_mlx90640` + `board` (Blinka) over I²C *(external)* | |

### 10.2 Key input parameters

| Parameter | Default | Significance |
|---|---|---|
| `mock` | `false` | Synthetic 22 °C ambient + 35 °C blob vs. real sensor |
| `publish_rate_hz` | 4.0 | Matches the sensor's configured `REFRESH_4_HZ` |
| `thermal_frame` | `thermal_link_optical` | Matches `thermal.xacro` (mounted pitched 0.2 rad down for the low dog) |
| `dog_temp_min` / `dog_temp_max` | 30.0 / 40.0 °C | **The SYS-PER-3 temperature window, literally encoded** |
| `min_blob_area` | 8 px | SYS-PER-3's "≥ N pixels" with N=8 (of 768 total) |
| `i2c_bus` / `i2c_address` | 1 / 0x33 | Pi I²C wiring (per design: thermal on the Pi, not the Jetson, avoiding I²C clock-stretch issues) |

### 10.3 Runtime process architecture

One node, `thermal_node`, on a 4 Hz timer:

| Interface | Direction | Type | Rate |
|---|---|---|---|
| `/thermal/image` | pub | `sensor_msgs/Image`, **32×24, encoding `32FC1`** (raw °C floats, step 128 B) | 4 Hz |
| `/thermal/blob` | pub | `billiebot_interfaces/ThermalBlob` — centroid (cx, cy), area, max/mean temp, `is_dog_candidate` | 4 Hz **only when** ≥8 in-window pixels exist (silent otherwise) |

Blob algorithm: threshold all pixels into [30, 40] °C → if count ≥ 8, publish centroid + stats. It is a *global* threshold count, not connected-component analysis — two warm objects merge into one "blob" (adequate for a single-dog apartment, worth knowing for verification).

**Mock:** ambient 22±0.5 °C with a circular ~45 px blob at 35±1 °C centered at (16, 12) — always exceeds the 8 px gate, so `/thermal/blob` publishes every frame with `is_dog_candidate: true`, `mean_temp ≈ 35`. (Downstream note: 35 °C > the 33 °C SLEEPING cutoff in `state_fusion`, so mock thermal biases fusion toward RESTING/ACTIVE, never SLEEPING.)

### 10.4 Measurable outputs

| Output | Measurement | Expected |
|---|---|---|
| Image stream | `ros2 topic hz /thermal/image` → 4 Hz; `echo --once` shows width 32, height 24, encoding `32FC1` — **exactly the VERIFICATION.md criterion** | RViz/Foxglove need a colormap for 32FC1; values are literal °C |
| Blob stream | `ros2 topic echo /thermal/blob` | Mock: area ≈ 45, mean ≈ 35 °C, candidate true @ 4 Hz. Real: publishes only when a warm body is in view |
| **Physical (real)** | Hold a hand / have the dog at ≤1.5 m; then remove | Blob appears with plausible temps (30–37 °C), disappears when clear; works with lights **off** — the darkness half of SYS-PER-3 |
| Range test | Dog at 1.5 m per SYS-PER-3 | area ≥ 8 px still achieved (55° FOV, 32 px across) |

### 10.5 Requirements traceability

| Requirement | Relationship |
|---|---|
| **SYS-PER-3** (warm body 30–40 °C, ≥N px, in darkness, ≤1.5 m, Verify: T) | **Directly implemented** — thresholds are literal parameters. TC-09 (thermal imaging) + TC-10 (blob detection) both land here |
| **SYS-STL-1** | Enabler — `is_dog_candidate` blobs and `mean_temp` are fusion inputs (the SLEEPING/RESTING discriminator in `state_fusion` is thermal temperature) |
| **SYS-PER-5** | Compensator — the design's night-vision gap plan is "rely on the thermal camera at night for MVP" |
| Design §5.2 `thermal_node + thermal_blob` row | Design shows two nodes; implemented as one node with two publishers — functionally equivalent |

---

## 11. Rung 10 — NoIR Camera

```bash
ros2 launch billiebot_bringup 10_noir.launch.py mock:=true
```

### 11.1 Referenced files

| File | Role |
|---|---|
| `billiebot_bringup/launch/10_noir.launch.py` | Rung entry — `noir_cam_node` standalone, only `mock` passed |
| `billiebot_perception/billiebot_perception/noir_cam_node.py` | Node source (picamera2 + mock) |
| External: `picamera2`/libcamera on the Pi *(external)* | |

### 11.2 Key input parameters

| Parameter | Default | Significance |
|---|---|---|
| `mock` | `false` | Synthetic dark-grey frames vs. CSI capture |
| `publish_rate_hz` | 5.0 | Frame rate |
| `camera_frame` | `noir_link_optical` | Matches `noir_camera.xacro` |
| `width` / `height` | 640 / 480 | RGB888 still-configuration capture size |

### 11.3 Runtime process architecture

One node, `noir_cam_node`, on a 5 Hz timer:

| Interface | Direction | Type | Rate |
|---|---|---|---|
| `/noir/image` | pub | `sensor_msgs/Image` 640×480 `rgb8` | 5 Hz (≈4.6 MB/s raw — noteworthy if ever bridged across the Wi-Fi DDS link; currently **no node subscribes to it at all**) |

**Mock:** uniform dark-grey (RGB 40,40,40) frames simulating low light. **Real:** `Picamera2` still-configuration capture loop.

This rung is a *sensor-liveness* rung only: no detector, classifier, or logger consumes `/noir/image` anywhere in the codebase. It exists to prove the CSI/night-imaging hardware path called for by SYS-PER-5.

### 11.4 Measurable outputs

| Output | Measurement | Expected |
|---|---|---|
| Image stream | `ros2 topic hz /noir/image` → 5 Hz — the sole VERIFICATION.md criterion | |
| Image content | Foxglove/rqt_image_view | Mock: flat dark grey. Real: recognizable scene; in darkness, IR-sensitive imagery (limited without an illuminator) |
| **Physical (real)** | Lights off + 850 nm source (if fitted) | Scene visible in the image where a normal camera sees black |

### 11.5 Requirements traceability

| Requirement | Relationship |
|---|---|
| **SYS-PER-5** (low-light detection via NoIR when lux < threshold, Verify: D) | **Partial at best** — imagery is published, but (a) no low-light *detector* consumes it (the requirement says *detect*, not *image*), (b) no lux thresholding/night-mode switching exists, and (c) the design's own HW gap list notes the required IR illuminator is not yet fitted. **Could** satisfy SYS-PER-5 by feeding `/noir/image` to a YOLO instance (design reserved Jetson GPU headroom for exactly this) plus the illuminator |
| TC coverage | **None** — TC-01…TC-22 contain no NoIR test; `run_all_mock_tests.sh` never checks `/noir/image` (traceability gap, Appendix A) |
| Design §5.2 `noir_cam` row | Matches (`/noir/image (night mode)`), with "night mode" logic not yet present |

---

## 12. Rung 11 — Audio

```bash
ros2 launch billiebot_bringup 11_audio.launch.py mock:=true
```

### 12.1 Referenced files

| File | Role |
|---|---|
| `billiebot_bringup/launch/11_audio.launch.py` | Rung entry; includes the package launch below |
| `billiebot_audio/launch/audio.launch.py` | Starts both audio nodes **with `audio.yaml`** (unlike the perception rungs, this rung does load its config) |
| `billiebot_audio/config/audio.yaml` | Classifier + speaker parameters |
| `billiebot_audio/billiebot_audio/audio_classifier.py` | YAMNet classifier + DoA node |
| `billiebot_audio/billiebot_audio/speaker_node.py` | `/speak` action server |
| `billiebot_interfaces/msg/AudioEvent.msg`, `billiebot_interfaces/action/Speak.action` | Interfaces |
| External: `tflite_runtime` (or TF), `sounddevice`, `pyusb`, YAMNet `yamnet.tflite` + `yamnet_class_map.csv`, ALSA `aplay` *(external)* | |

### 12.2 Key input parameters

| Node | Parameter | Value | Significance |
|---|---|---|---|
| classifier | `publish_rate_hz` | 2.0 | Classification tick (each tick records a chunk in real mode) |
| classifier | `chunk_duration_sec` / `sample_rate` | 0.975 s / 16 kHz | YAMNet's exact input format (15,600 samples) |
| classifier | `confidence_threshold` | 0.3 | Score gate on the top YAMNet class |
| classifier | `energy_threshold_db` | −30 dB | RMS pre-gate: silence is never classified |
| classifier | `model_path` | `''` | **Real mode requires the operator to supply yamnet.tflite; empty ⇒ error log, no output** (same failure pattern as rung 07) |
| speaker | `min_interval_sec` | 10.0 | **SYS-PLT-6 rate limit** — goals within 10 s of the last playback are `REJECT`ed |
| speaker | `max_volume` | 0.5 | Volume clamp (dog-welfare) |
| speaker | `sounds_dir` | `''` | WAV directory for real playback via `aplay -D plughw:0,0` |

### 12.3 Runtime process architecture

Two nodes:

**`audio_classifier`** (2 Hz timer):

| Interface | Direction | Type | Rate |
|---|---|---|---|
| `/audio/events` | pub | `billiebot_interfaces/AudioEvent` — `event_type` enum {BARK=0, WHINE=1, HOWL=2, LOUD_NOISE=3, SILENCE=4}, confidence, `doa_deg` [0,360), `yamnet_label`, `energy_db` | intermittent (event-driven) |

Real pipeline per tick: record 0.975 s mono @16 kHz (`sounddevice`) → RMS energy gate (−30 dB) → YAMNet TFLite inference → top class mapped through `YAMNET_DOG_CLASSES` (Bark/Bow-wow/Yip/Growling→BARK, Howl→HOWL, Whimper→WHINE, anything else above threshold→LOUD_NOISE) → DoA read via USB vendor control transfer to VID 0x2886 / PID 0x0018. **Risk:** that VID/PID is the ReSpeaker *4-Mic Array (XVF-3000 era)* ID; the design specifies the **XVF3800**, which may enumerate differently — DoA would silently return 0.0 (the code's fallback) (Appendix B-14).

Mock per tick (2 Hz): 15 % chance BARK (conf ≈0.75, random DoA), 5 % chance WHINE (conf ≈0.6) ⇒ expected ≈0.3 barks/s + 0.1 whines/s — a deliberately bark-heavy stream that exercises downstream BARKING fusion and stress-proxy math.

**`speaker_node`**:

| Interface | Direction | Type | Notes |
|---|---|---|---|
| `/speak` | **action server** | `billiebot_interfaces/action/Speak` (goal: `sound_id`, `volume`; feedback: `progress`; result: `success`, `message`) | Goal callback enforces the 10 s rate limit *before* acceptance; volume clamped to 0.5. Mock: simulated 1 s playback with 10 feedback ticks. Real: `aplay` subprocess (30 s timeout). Note: `volume` is computed but never applied to `aplay` (no `-v` mechanism) — real loudness control relies on ALSA mixer state (minor gap) |

### 12.4 Measurable outputs

| Output | Measurement | Expected |
|---|---|---|
| Events | `ros2 topic echo /audio/events` | Mock: BARK/WHINE events, several per 10 s, DoA uniformly random. Real: events **only** when actual barks/loud sounds occur — clap test → LOUD_NOISE; recorded Billie barks → BARK (the SYS-PER-4 recall test) |
| DoA sanity (real) | Bark/clap from a known bearing | `doa_deg` within ±15° of truth (SYS-PER-4 figure) |
| Speak action | `ros2 action send_goal /speak billiebot_interfaces/action/Speak "{sound_id: test.wav, volume: 0.3}"` | Mock: feedback 0.1→1.0 over ~1 s, success. Real: **audible sound** (physical output) |
| Rate limiting | Send a second goal within 10 s | Goal **rejected** — directly observable SYS-PLT-6 evidence |
| Action discovery | `ros2 action list` | `/speak` present |

### 12.5 Requirements traceability

| Requirement | Relationship |
|---|---|
| **SYS-PER-4** (bark/whine/howl/loud detection ≥80 % recall + DoA ±15°, Verify: T) | **Mechanism satisfied** (classification + DoA plumbing + energy gating); the recall figure needs the recorded-Billie test set (Build Phase 4), and DoA carries the XVF3800 VID/PID risk. TC-11 |
| **SYS-PLT-6** (no sudden loud sounds; speaker rate-limited, Verify: I) | **Satisfied by inspection** — 10 s minimum interval, 0.5 volume clamp, and goal-time rejection are all in `speaker_node.py`; the declared-but-unused `fade_in_sec` param shows the fade-in intent is not yet implemented (minor) |
| **SYS-FND-2** (audio DoA re-prioritizes search) | Enabler — `doa_deg` reaches `mission_controller`, which currently only logs it (rung 13, Appendix B-5) |
| **SYS-EXT-1** (Speak as a uniform action server) | **Satisfied** — `/speak` here plus the `/mission/speak` wrapper in rung 13 |
| Design §5.2 `audio_classifier`/`speaker_node` rows | Match (`/audio/events` out; `/speak` rate-limited in) |

---

## 13. Rung 12 — Cognition

```bash
ros2 launch billiebot_bringup 12_cognition.launch.py
```

(No `mock` argument — all four nodes are pure software; "mock" is meaningless for them.)

### 13.1 Referenced files

| File | Role |
|---|---|
| `billiebot_bringup/launch/12_cognition.launch.py` → `billiebot_cognition/launch/cognition.launch.py` | Starts all four cognition nodes with `cognition.yaml` (+ `rooms.yaml` path for the logger) |
| `billiebot_cognition/config/cognition.yaml` | All four nodes' parameters |
| `billiebot_cognition/config/rooms.yaml` | Map-frame room bounding boxes (placeholders pending mapping) |
| `billiebot_cognition/billiebot_cognition/state_fusion.py` | Evidence fusion → `/billie/state` |
| `billiebot_cognition/billiebot_cognition/dog_logger.py` | SQLite WAL event log |
| `billiebot_cognition/billiebot_cognition/daily_report.py` | Scheduled report generator (also `--standalone` CLI) |
| `billiebot_cognition/billiebot_cognition/report_server.py` | FastAPI HTTP server on :8080 |
| `billiebot_interfaces/msg/DogState.msg`, `srv/GetDogState.srv` | Interfaces |
| `billiebot_bringup/scripts/verify_rung_12.sh` | Verification script |
| External: `fastapi`, `uvicorn`, optional `markdown`, `jinja2`, `matplotlib`, `pyyaml` *(external, all soft-degrading except fastapi/uvicorn which disable the server)* | |

### 13.2 Key input parameters

| Node | Parameter | Value | Significance |
|---|---|---|---|
| state_fusion | `publish_rate_hz` | 2.0 | `/billie/state` cadence |
| state_fusion | `window_sec` | 10.0 | Sliding evidence window (design §5.3: "10 s sliding window") |
| state_fusion | `hysteresis_sec` | 3.0 | Minimum dwell before a state change is accepted (anti-flapping) |
| state_fusion | `bark_rate_stress_threshold` | 0.3 barks/s | Normalizer for `stress_proxy = min(1, bark_rate/0.3)` (SYS-EXT-4) |
| dog_logger | `db_path` | `/var/lib/billiebot/billie_events.db` | **System path — the node `os.makedirs` this; without pre-created, user-writable `/var/lib/billiebot` the node crashes on startup** (Appendix B-15) |
| dog_logger | `snapshot_dir` / `enable_snapshots` | `/var/lib/billiebot/snapshots` / true | Snapshot JPEGs on transitions — **currently zero-byte placeholders** (Appendix B-16) |
| daily_report | `generate_hour`/`generate_minute` | 23:55 | Design §3.6 says 23:30 — minor deviation (Appendix B-17) |
| report_server | `host`/`port` | 0.0.0.0 / 8080 | LAN-reachable (SYS-RPT-2) |

### 13.3 Runtime process architecture

Four nodes:

**`state_fusion`** — the SYS-STL-1 core. Timestamped deques of the last 10 s of evidence; 2 Hz fusion tick:

| Interface | Direction | Type |
|---|---|---|
| `/dog/detections_3d` | sub | `DogDetection3D` (visual evidence) |
| `/thermal/blob` | sub | `ThermalBlob` (thermal evidence, `is_dog_candidate` filtered) |
| `/audio/events` | sub | `AudioEvent` (bark/whine counting) |
| `/dog/pose_map` | sub | `PoseStamped` (position memory) |
| `/billie/state` | pub @ 2 Hz | `DogState` — state enum, confidence, position, room, `context[6]`, `stress_proxy`, `state_duration` |
| `/get_dog_state` | service | `GetDogState` (empty → current DogState + `dog_found`) |

Decision cascade (per 10 s window): ≥2 BARKs → **BARKING** (conf 0.5+0.1/bark, cap 0.9); else visual present → if also thermal: mean temp <33 °C & no audio → **SLEEPING**; <36 °C & no audio → **RESTING**; else **ACTIVE**; visual only → **ACTIVE** (conf ×0.8); thermal only → **RESTING** (conf 0.4); nothing → **NOT_FOUND**. A 3 s hysteresis gates all transitions. `context = [n_visual, n_thermal, n_barks, n_whines, bark_rate, stress_proxy]` — the SYS-STL-3/SYS-EXT-3 forward-compatible feature vector. Deviations from design §5.3: no bbox-motion-energy or displacement test for ACTIVE, no 120 s static requirement for SLEEPING (thermal temperature is used as the proxy instead), and `room` is only echoed from input (never computed here — always empty; room attribution actually happens in `dog_logger`).

**`dog_logger`** — subscribes `/billie/state`; writes to SQLite (WAL mode, schema `dog_events(timestamp, epoch, state, state_id, confidence, x, y, room, image_path, context_json, action='OBSERVE', outcome='', stress_proxy)`) **on every state transition plus a 60 s periodic heartbeat row**. Room is derived from position via `rooms.yaml` bounding boxes (first match wins; overlapping placeholder boxes exist — e.g. `hallway` overlaps `living_room`). Snapshot files are created but empty (no image topic subscription).

**`daily_report`** — 60 s check timer; at 23:55 queries the day's rows, aggregates per-state durations (inter-event gaps capped at 300 s), bark log, room counts; renders Jinja2 Markdown to `reports/report_YYYY-MM-DD.md` + matplotlib timeline PNG. Also runnable as `daily_report --standalone [date]` for systemd-timer use (design §5.1).

**`report_server`** — FastAPI in a daemon thread: `GET /` (HTML-rendered latest report), `/latest` (raw Markdown), `/health` (`{"status": "ok", "reports": N}`), `/reports` (list).

**Standalone rung 12** (no perception running): fusion sees no evidence → `/billie/state` publishes **NOT_FOUND at 2 Hz** — still fully verifiable at the interface level, which is exactly what `verify_rung_12.sh` checks.

### 13.4 Measurable outputs

| Output | Measurement | Expected |
|---|---|---|
| Fused state | `ros2 topic hz /billie/state` → 2 Hz; `echo` | Standalone: `state: 0` (NOT_FOUND). With rungs 07/09/11 mock feeding it: transitions among ACTIVE/RESTING/BARKING visible, confidence populated, `context[6]` non-zero, `stress_proxy` rising with mock bark bursts |
| State service | `ros2 service call /get_dog_state billiebot_interfaces/srv/GetDogState` | Returns current state + `dog_found` |
| HTTP health | `curl http://localhost:8080/health` | `{"status":"ok","reports":N}` — the VERIFICATION.md criterion |
| Report retrieval | `curl http://localhost:8080/latest`; browser to `/` | Markdown/HTML report (after ≥1 generation) |
| Persistence | `sqlite3 /var/lib/billiebot/billie_events.db 'SELECT state, COUNT(*) FROM dog_events GROUP BY 1'` | Rows accumulate: transitions + 60 s heartbeats; `PRAGMA journal_mode` returns `wal` (SYS-STL-4 evidence) |
| On-demand report | `ros2 run billiebot_cognition daily_report --standalone` | `report_<date>.md` + `timeline_<date>.png` in the reports dir — avoids waiting for 23:55 |
| Script | `./scripts/verify_rung_12.sh` | state topic + service PASS; server health PASS or WARN (fastapi treated as optional) |
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
