sean-mackenzie/billie-bot-claude/docs/md/VERIFICATION.md

# BillieBot — Verification & Bringup Guide

## Build

```bash
cd billiebot_ws
colcon build --symlink-install
source install/setup.bash
```

## Bringup Ladder

Each rung builds on the previous. Use `mock:=true` for hardware-free testing.

**Rungs 05, 06, 14 and `jetson.launch.py` need a map** — they start `map_server` + AMCL, and `mock:=true` does not change that. The `map` argument defaults to empty and fails quietly if you omit it; see [INSTALLATION_AND_SETUP.md §1.6 "Why Nav2 needs a map"](INSTALLATION_AND_SETUP.md#nav2-needs-a-map). Set it once per shell and reuse it below:
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
