sean-mackenzie/billie-bot-claude/billiebot_ws/src/billiebot_description/urdf/robot_core.xacro

<?xml version="1.0"?>
<robot xmlns:xacro="http://www.ros.org/wiki/xacro">

    <xacro:include filename="inertial_macros.xacro" />

    <!-- Materials -->
    <material name="white"><color rgba="1 1 1 1"/></material>
    <material name="orange"><color rgba="1 0.3 0.1 1"/></material>
    <material name="blue"><color rgba="0.2 0.2 1 1"/></material>
    <material name="black"><color rgba="0 0 0 1"/></material>
    <material name="red"><color rgba="1 0 0 1"/></material>
    <material name="dark_grey"><color rgba="0.3 0.3 0.3 1"/></material>

    <!-- BASE LINK -->
    <link name="base_link"/>

    <!-- CHASSIS -->
    <joint name="chassis_joint" type="fixed">
        <parent link="base_link"/>
        <child link="chassis"/>
        <origin xyz="0 0 0"/>
    </joint>

    <link name="chassis">
        <visual>
            <origin xyz="0.09 0 0.0635" rpy="0 0 0"/>
            <geometry>
                <box size="0.28 0.26 0.09"/>
            </geometry>
            <material name="white"/>
        </visual>
        <collision>
            <origin xyz="0.09 0 0.0635" rpy="0 0 0"/>
            <geometry>
                <box size="0.28 0.26 0.09"/>
            </geometry>
        </collision>
        <xacro:inertial_box mass="0.5" x="0.28" y="0.26" z="0.09">
            <origin xyz="0.09 0 0.0635" rpy="0 0 0"/>
        </xacro:inertial_box>
    </link>

    <!-- LEFT WHEEL -->
    <joint name="left_wheel_joint" type="continuous">
        <parent link="base_link"/>
        <child link="left_wheel"/>
        <origin xyz="0 0.149 0" rpy="-${pi/2} 0 0"/>
        <axis xyz="0 0 1"/>
        <limit effort="1.0" velocity="10.0"/>
    </joint>

    <link name="left_wheel">
        <visual>
            <geometry>
                <cylinder length="0.026" radius="0.034"/>
            </geometry>
            <material name="blue"/>
        </visual>
        <collision>
            <geometry>
                <sphere radius="0.034"/>
            </geometry>
        </collision>
        <xacro:inertial_cylinder mass="0.1" length="0.026" radius="0.034">
            <origin xyz="0 0 0" rpy="0 0 0"/>
        </xacro:inertial_cylinder>
    </link>

    <!-- RIGHT WHEEL -->
    <joint name="right_wheel_joint" type="continuous">
        <parent link="base_link"/>
        <child link="right_wheel"/>
        <origin xyz="0 -0.149 0" rpy="${pi/2} 0 0"/>
        <axis xyz="0 0 -1"/>
        <limit effort="1.0" velocity="10.0"/>
    </joint>

    <link name="right_wheel">
        <visual>
            <geometry>
                <cylinder length="0.026" radius="0.034"/>
            </geometry>
            <material name="blue"/>
        </visual>
        <collision>
            <geometry>
                <sphere radius="0.034"/>
            </geometry>
        </collision>
        <xacro:inertial_cylinder mass="0.1" length="0.026" radius="0.034">
            <origin xyz="0 0 0" rpy="0 0 0"/>
        </xacro:inertial_cylinder>
    </link>

    <!-- CASTER WHEEL -->
    <joint name="caster_wheel_joint" type="fixed">
        <parent link="chassis"/>
        <child link="caster_wheel"/>
        <origin xyz="0.18 0 0.0185" rpy="0 0 0"/>
    </joint>

    <link name="caster_wheel">
        <visual>
            <geometry>
                <sphere radius="0.0525"/>
            </geometry>
            <material name="black"/>
        </visual>
        <collision>
            <geometry>
                <sphere radius="0.0525"/>
            </geometry>
        </collision>
        <xacro:inertial_sphere mass="0.1" radius="0.0525">
            <origin xyz="0 0 0" rpy="0 0 0"/>
        </xacro:inertial_sphere>
    </link>

    <gazebo reference="caster_wheel">
        <mu1 value="0.0"/>
        <mu2 value="0.0"/>
    </gazebo>

</robot>
