sean-mackenzie/billie-bot-claude/(commit log)

2026-07-02 Add BillieBot MVP: complete ROS 2 software stack
    10 packages implementing autonomous dog-monitoring robot:
    - billiebot_interfaces: custom msgs/srvs/actions (DogState, AudioEvent, etc.)
    - billiebot_description: URDF with 8 sensor frames (OAK-D, thermal, NoIR, mic, IMU)
    - billiebot_base: diff-drive bridge with mock serial, battery monitor, e-stop
    - billiebot_navigation: EKF, SLAM, AMCL, Nav2 (DWB controller) configs
    - billiebot_perception: OAK-D spatial detector, dog locator, thermal, NoIR
    - billiebot_audio: YAMNet classifier with DoA, rate-limited speaker
    - billiebot_cognition: state fusion, SQLite WAL logger, daily report + web server
    - billiebot_mission: BT nodes (C++), action servers, miss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
    [billiebot.urdf.xacro, camera.xacro, imu.xacro, inertial_macros.xacro, lidar.xacro, mic_array.xacro, noir_camera.xacro, oakd_lite.xacro]
2026-07-05 added screenshots of mermaid graphs from MBSE_System_Decomposition.md in case they don't render.
2026-07-10 Fix mock-mode bringup: launch bugs, Nav2 config, mock scan, dev container
    Get the full mock stack (14_full_bringup.launch.py mock:=true) running
    end-to-end on the Mac dev container, through Nav2 activation with a real
    apartment map:
    - description.launch.py: wrap xacro output in ParameterValue(value_type=str)
    so robot_description survives Humble's YAML parameter parsing
    - nav2_params.yaml: use Humble plugin names (nav2_navfn_planner/NavfnPlanner,
    nav2_behaviors/Spin|BackUp|Wait) — the :: forms are Iron+ and made
    planner_server/behavior_server fail to configure
    - dog_locator.py: import tf2_geometry_msgs so tf_buffer.transform() can
    handle PointStamped (node crashed on first detectio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
    [dog_locator.py, mock_scan.py]
2026-07-10 Add FOXGLOVE_GUIDE.md: Foxglove Studio companion to VERIFICATION.md
    Teaches Foxglove Studio rung-by-rung through the 14-rung bringup ladder,
    twice: Part 1 in mock mode (hardware-free, Docker on the Mac) building
    every skill cumulatively, and Part 2 on the real robot (bridge placement
    per machine, safety, sensor sanity checks, real SLAM map building and
    saving). Includes an RViz-to-Foxglove translation table, a FAQ mapping
    common questions to sections, and appendices covering bag recording and
    replay (MCAP), layout sharing, User Scripts, standalone depthai-ros for
    full OAK-D streams, and troubleshooting.
    Commands, topics, types, rates, and service payloads verified against a
    live mock stack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
2026-07-12 Resolve GAP-19: align all references to Raspberry Pi 5
    The secondary-compute board is a Raspberry Pi 5 (per the system design
    doc, the source of truth). Naming had drifted to "Pi 4" / "Pi 4/5" across
    the README, guides, MBSE diagrams, and CycloneDDS config comments.
    Sweep every board reference to Pi 5:
    - README.md (hardware table + launch comment)
    - docs/md/VERIFICATION.md, MEASURE_ME.md, BRINGUP_LADDER_ANALYSIS.md
    - docs/md/MBSE_SYSTEM_DECOMPOSITION.md (table, BDD text, mermaid subgraphs)
    - docs/md/INSTALLATION_AND_SETUP.md (target list, hw table, §2.3, Appendix D)
    - billiebot_ws/.../config/cyclonedds.xml (peer comments)
    Drop the now-obsolete "works on both boards" drift caveats and mark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
2026-07-12 added master wiring schemdatic pdf.
2026-07-17 Resolve GAP-5 & GAP-6: single owner for odom->base_link TF, single EKF instance
    GAP-5 (closes #4): the EKF is now the sole odom->base_link broadcaster.
    - base_driver.yaml: publish_tf default false
    - base.launch.py / 02_base.launch.py: publish_tf launch arg (default false)
    so rung-02-only bench work can restore the base broadcast
    - base_bridge.py: only create the TransformBroadcaster when enabled, so a
    disabled bridge registers no idle /tf publisher (keeps TC-24 meaningful)
    GAP-6 (closes #5): removed the duplicate ekf_filter_node from
    navigation.launch.py; rung 03's EKF is the single instance. Every include
    path (rungs 06/14, jetson.launch.py) reaches it via 05_amcl -> 03_ekf.
    Docstring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
    [base_bridge.py, base_driver.yaml]
2026-07-17 Resolve GAP-4: Nav2 consumes /odometry/filtered instead of raw /odom
    Set odom_topic: /odometry/filtered for bt_navigator and, per the
    runtime audit, also for controller_server, whose own odom_topic
    parameter had been silently defaulting to raw odom (NAV-08 covers all
    Nav2 consumers). ekf.yaml's odom0 input correctly stays raw.
    Verified in the billiebot-dev container (rung 06 mock stack): both
    params read /odometry/filtered, its subscribers are bt_navigator +
    controller_server, /odom's only subscriber is the EKF, and
    verify_rung_03.sh / verify_rung_06.sh pass.
    Docs updated per the three-doc rule (resolution plan sheet + tables,
    MBSE NAV-08 row / IBD-03 connectors + diagram / §5.4 register,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
2026-07-17 added physical layout schematic pdf
2026-07-26 Update Jetson/Pi static IPs to 192.168.42.x subnet
    Network plan changed the robot's subnet from 192.168.1.0/24 to
    192.168.42.0/24: Jetson Orin Nano is now 192.168.42.100, Raspberry Pi 5
    is now 192.168.42.101 (host octets unchanged). Updates the CycloneDDS
    peer config plus all doc references (INSTALLATION_AND_SETUP.md,
    FOXGLOVE_GUIDE.md, BRINGUP_LADDER_ANALYSIS.md,
    MBSE_SYSTEM_DECOMPOSITION.md), and drops the MEASURE_ME.md CycloneDDS
    entry since these are now confirmed fixed addresses rather than
    placeholders.
2026-07-28 Address the lidar by a stable /dev/serial/by-id path (GAP-20)
    01_lidar.launch.py hardcoded the RPLidar A1 at /dev/ttyUSB1 while
    base_driver.yaml addressed the Arduino by its /dev/serial/by-id/ path.
    ttyUSBn indices are assigned in plug-in order, so a replug or a reboot
    with different USB timing could swap the two devices and take rung 01 --
    and every rung above it -- down with a failure that looks like hardware.
    Move the lidar's parameters into billiebot_bringup/config/lidar.yaml on
    the observed CP2102 by-id path, loaded by 01_lidar.launch.py. Config-file
    -at-the-leaf mirrors base.launch.py and avoids threading a launch argument
    through the four-level include chain (14/jetson -> 06_nav2 ->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
2026-07-28 Make the Jetson hardware bringup steps runnable, not implied
    The "still owed on the Jetson" steps for GAP-20 were not executable as
    written: the replug acceptance test lived only inside the GAP-20 resolution
    sheet, VERIFICATION.md rung 01 never named its verify script, verify scripts
    were written as ./scripts/verify_rung_NN.sh (which only resolves from
    billiebot_ws/src/billiebot_bringup/), and nothing said that ros2 launch
    blocks so the checks need a second SSH session.
    - INSTALLATION_AND_SETUP.md 2.2.4: make the re-login an explicit exit + ssh
    pair rather than prose (the dialout group change is the most common silent
    failure), and hand off to VERIFICATION.md for first bringup.
    - VERIFI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
2026-07-28 Track required empty ROS package directories
    billiebot_description/CMakeLists.txt installs urdf, launch, rviz, and
    meshes directories via install(DIRECTORY ...), which requires each
    directory to physically exist. Git does not track empty directories,
    so a fresh clone was missing rviz/ and meshes/, breaking
    colcon build --symlink-install with:
    ament_cmake_symlink_install_directory() can't find
    '.../billiebot_description/rviz'
    Add .gitkeep to both directories so they exist after a fresh clone.
    Verified with a clean colcon build in the billiebot-dev container.
2026-07-28 Document required map for Jetson mock launch
    The documented verification command `jetson.launch.py mock:=true` omitted the
    `map` argument, which defaults to empty. mock:=true mocks the hardware
    interfaces but does not remove Nav2's need for a map: the launch chain reaches
    localization.launch.py, so map_server logs "yaml-filename parameter is empty",
    AMCL waits forever, and the navigation lifecycle never activates.
    Every operational command that starts Nav2 now supplies a map, using the
    installed package-share path so it is independent of username and clone
    location. Adds one authoritative explanation in INSTALLATION_AND_SETUP.md
    Part 1.6, success criteria, a troubleshooting checklist, and a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
2026-07-29 added YOLOv8n model to local directory on the Jetson: /home/sean/billiebot/models/, and updated perception.yaml to include model_path.
2026-08-01 Close GAP-11: OAK-D model_path fail-loud + launch wiring
    Real mode now treats an empty/missing model_path, a missing depthai
    install, or any pipeline/device init failure as fatal (log ERROR,
    exit non-zero) instead of leaving the node alive and silently
    publishing nothing. 07_oakd.launch.py now actually loads
    perception.yaml (previously only passed {'mock': mock}, so the
    model_path set there never reached the node); bundled the same
    one-line fix into 09_thermal.launch.py and 10_noir.launch.py, which
    shared the bug.
    Updates the three tracking docs and closes the matching GitHub issue.
    Closes #12
    [oakd_dog_detector.py]
2026-08-01 Add billiebot_sensor_tests bench-test suite and sensor production fixes
    Implements the full BillieBot sensor bench-test plan (OAK-D, MLX90640,
    NoIR, XVF3800) as an independent ament_python package, separate from
    billiebot_tests' mock-only stack smoke tests. Includes acquisition/
    scoring nodes, launch files, an orchestrator, a Foxglove layout, and
    90 unit tests exercising pure metrics against synthetic fixtures with
    no hardware required.
    Also lands the narrowly-scoped production fixes the bench plan called
    for: the OAK-D bounding-box normalized-coordinate bug (Appendix B-11),
    optional NoIR AF/exposure/metadata controls, and the audio_classifier
    continuous-capture refactor replacing the block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
    [audio_classifier.py]
2026-08-02 Sync sensor bench test plan with billiebot_sensor_tests implementation
    The spec doc was committed as-is when the package was implemented and
    never reconciled with the as-built code. This pass fixes the package-
    name inconsistency (billiebot_sensors_tests/billiebot_tests -> the
    correct billiebot_sensor_tests), corrects the package layout tree and
    the OAK-D preview-param defaults (spec said default true, shipped
    false, matching the plan's own "default off" intent), and adds inline
    Implementation note callouts wherever the as-built package is narrower
    than the original spec (no representative-frame export, manifest
    parameters field currently empty, preflight results not yet gating
    pass/fail, a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
2026-08-02 added sensor specifications reference docs.
2026-08-08 added PDF version of sensor bench test plan and changed MLX90640 refresh rate from 4 hz to 8 Hz (but note that this should raise the actual frame rate from 2 Hz to 4 Hz)
2026-08-09 fixed issues with audio classifier and audio bench tests. Also pointed audio classifier model path to actual YAMNet model.
    [audio.yaml, audio_classifier.py]
2026-08-09 fixed _get_doa() function to correctly parse direction of arrival from XVF3800--file: audio-classifier.py
    [audio_classifier.py]
2026-08-11 Pin numpy==1.26.4 and depthai==2.32.0.0, install usbutils for USB preflight
    Three hardware-test findings, applied consistently to every place the
    BillieBot runtime dependencies are installed:
    - numpy==1.26.4 everywhere. The tflite-runtime and depthai wheels are
    built against the NumPy 1.x ABI; an unpinned install now resolves to
    2.x and those imports fail at load time.
    - depthai==2.32.0.0 everywhere. oakd_dog_detector.py and the bench
    oakd_bench_publisher.py use the DepthAI v2 API (dai.Pipeline(),
    pipeline.create(dai.node.*), XLinkOut, setBlobPath, readCalibration).
    3.x is a breaking rewrite; neither node is ported to it, so this pins
    rather than migrates.
    - usbutils wherever se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
    [preflight.py]
2026-08-11 replaced slow .tolist() conversions with optimized NumPy implementation, increasing the data streat rate from 0.33 Hz to 5 Hz.
2026-08-12 Separate raw acquisition topics from low-bandwidth Foxglove visualization
    A UT-OAK-02 run showed all three authoritative OAK-D topics publishing at
    ~5.0 Hz with rosbag2 capturing ~279 messages each over ~55 s (~3 GiB) and
    topic_rate_monitor.json passing, while Foxglove received ~4-5 messages per
    topic (~0.12 Hz) and the panels appeared frozen.
    Root cause is transport, not acquisition. The shipped layout subscribed the
    OAK-D tab directly to the raw set: 1080p bgr8 at 5 Hz is 248.8 Mbit/s, plus
    20.5 Mbit/s of raw depth and 7.7 Mbit/s of stride-4 points -- ~277 Mbit/s in
    total, far past a Wi-Fi link. foxglove_bridge drops messages for a client that
    cannot keep up rather than back-pressuring th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
2026-08-12 Keep the 990a99a point-cloud/data-payload optimizations after the merge
    The conflict resolution merging main into this branch kept `import array` and
    both `array.array('B', ...)` image payloads, but took this branch's
    `create_cloud_xyz32(header, points.tolist())` over main's
    `create_cloud_xyz32(header, points)`. That is the exact call 990a99a fixed to
    lift the authoritative cloud from 0.33 Hz to 5 Hz, and because the preview work
    factored cloud construction into a shared `_cloud_msg`, the regression would
    have run the conversion twice per frame.
    Measured in the billiebot-dev container, 16k points: 0.02 ms passing the
    ndarray vs 4.1 ms via .tolist() (~180x).
    The same defect class applied to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
    [preview.py, preview_node.py, test_preview.py]
2026-08-12 Wrap OAK-D image payloads in array.array like the real acquisition path
    rclpy's generated `data` setter (sensor_msgs/msg/_image.py) short-circuits when
    handed an array.array and otherwise walks the whole payload twice in pure
    Python to validate it before converting. That validation cost is what held
    oakd_bench_publisher at 0.33 Hz until 990a99a wrapped the real-mode publishes.
    An audit of every `msg.data = ...` assignment in the repo found three OAK-D
    sites still on the slow path. Measured in the billiebot-dev container on an
    M4 Pro:
    oakd_dog_detector._publish_preview_frame ~40 ms -> 0.04 ms
    (519 kB RGB + 512 kB depth, called twice per detector cycle)
    oakd_preview_overlay._on_p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
    [oakd_dog_detector.py, test_preview.py]
2026-08-12 During DT-OAK-01 testing, identified issues with detector pipeline implementation that prevented detections. Added YOLO parser configuration detail, which solved the issue. Also, temporarily added a 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
    [oakd_dog_detector.py]
2026-08-13 changes to analyze thermal frame.py to make it work with a stationary target.
2026-08-14 Align Pi deployment docs with the verified deployed configuration
    A verification pass against the deployed Raspberry Pi 5 Docker setup found
    three drifts in the installation guide. All three are documentation-only; no
    executable or configuration artifact in the repo changes.
    1. Pi Dockerfile path: the deployed file is ~/billiebot-docker/Dockerfile on
    the Pi host, not ~/billiebot-pi.Dockerfile. Updated the prose and the
    matching `docker build -f` command so they stay cross-consistent.
    2. Pi base image: the deployed Dockerfile begins FROM ros:humble-ros-base-jammy.
    Only the Raspberry Pi runtime example is changed -- docker/Dockerfile and the
    §1.3/§1.4 Mac dev-container instruct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
2026-08-14 added structured report on sensor bench test results to date. This document may get updated at a future date if additional testing is performed.
2026-08-14 added IMU and battery bench test plan.
2026-08-14 implement the Sensor Nano IMU + battery bench-test campaign
    Implements the approved verification spec in
    docs/md/BILLIEBOT_IMU_BATTERY_BENCH_TEST_PLAN.md for the new two-Arduino-Nano
    architecture: a dedicated Sensor Nano carrying a DFRobot SEN0253 (BNO055 +
    BMP280) and the battery-sense divider on A0.
    Adds five tests to billiebot_sensor_tests, all registered in TEST_REGISTRY and
    runnable through the standard run_sensor_test orchestrator:
    UT-IMU-01 Sensor Nano IMU/barometer acquisition
    UT-IMU-02 /imu/data contract + robot_localization compatibility
    UT-BAT-01 battery divider acquisition and voltage accuracy (operator-paced)
    UT-BAT-02 physical low-battery SAFE propagation
    UT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
2026-08-15 Drop the IMU sample when any BNO055 transaction fails
    Adafruit_BNO055 1.6.4 zeroes its result buffers and then discards the bool
    from its private readLen(): getQuat() at Adafruit_BNO055.cpp:466 and
    getVector() at :401 both return all-zero data on a NACKed or timed-out I2C
    read. read8(), which getCalibration() uses, is worse still -- it reuses one
    buffer for the register address and the reply, so a failed CALIB_STAT read
    decodes 0x35 into a fabricated cal_gyr=3/cal_acc=1/cal_mag=1.
    The existing quaternion norm gate caught the orientation case. Gyro and
    accelerometer reads could still fail independently and ship plausible zeros
    inside an otherwise valid I record, and no value check can close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
    [analyze_imu.py, protocol.py, sensor_nano.ino, test_sensor_nano_protocol.py]
2026-08-17 Add a Foxglove layout for the Sensor Nano IMU and battery bench tests
    The shipped billiebot_sensor_bench.json covers OAK-D/Thermal/NoIR/Audio and has
    no IMU, barometer, battery or mission-mode panels, so UT-IMU-01/02 and
    UT-BAT-01/02 currently run with no live operator view of the quantities they
    exercise. This adds a second, dedicated layout; the existing one is untouched.
    Four tabs, one per physical test, above a shared diagnostics + /rosout strip
    that stays visible on every tab:
    IMU Acquisition gyro, accel + |a|, roll/pitch/yaw, quaternion,
    barometer (dual axis), magnetometer, raw /imu/data
    IMU + EKF IMU yaw vs EKF yaw, 3D TF view, yaw-rate compar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
2026-08-18 added documents to import Value Properties into MSOSA.
    [Blocks.csv, Claude_BillieBot_Hardware_Cameo_Import.csv, Claude_BillieBot_Hardware_Specifications.csv, GPT_BillieBot_Cameo_Block_ValueProperty_Import.csv, GPT_BillieBot_Hardware_Component_Specifications.csv, ValueProperties.csv]
2026-08-19 push blocks and value properties that were actually imported and supporting documents
    [Blocks.csv, Blocks.xlsx, Blocks_SM.xlsx, Claude_BillieBot_Hardware_Cameo_Import.csv, Claude_BillieBot_Hardware_Specifications.csv, GPT_BillieBot_Cameo_Block_ValueProperty_Import.csv, GPT_BillieBot_Hardware_Component_Specifications.csv, ValueProperties.csv]
2026-08-20 Enforce conservative XVF3800 low-power production policy
    BillieBot uses the ReSpeaker XVF3800 for microphone capture, YAMNet
    classification, and DoA, but not its WS2812 LED ring or its onboard audio
    amplifier (speaker output is the separate MAX98357A/I2S path). Until now the
    firmware's boot defaults were simply trusted. Make the power state an explicit,
    verified production invariant instead:
    LED_EFFECT = 4 internal DoA mode, preserved
    X0D31 = 1 onboard amplifier disabled (active-low enable)
    X0D33 = 0 WS2812 LED-ring power off (active-high enable)
    X0D30 observed and reported only, NEVER written
    The policy is read-before-write and VOLATILE: a compli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
2026-08-20 Restore XVF3800 power policy immediately on USB reacquisition
    A re-enumerated XVF3800 comes back at firmware defaults -- WS2812 ring powered,
    onboard amplifier enabled. The cached handle was invalidated on a control
    failure and transparently reopened by _ensure_xvf_device() on the next DoA
    read, but nothing re-asserted the policy until the 30 s verification timer
    fired. An unplug/replug could therefore leave the LED ring lit and the
    amplifier powered for up to a full verification period while the node happily
    read DoA from the device.
    _read_doa_degrees() now detects a missing handle and, when enforcement is
    enabled, runs _apply_xvf_power_policy() before the reacquired device is trusted
    for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
    [audio_classifier.py, test_audio_classifier.py]
2026-08-21 added Signal catalog documents, which require manual review
    [claude_billiebot_signal_catalog.csv, gpt_billiebot_signal_catalog.csv]
2026-08-25 moved Motor Nano and Sensor Nano into a dedicated firmware package; create a RevA (old) and RevB (intended) copy of the Motor Nano motor controller firmware. The Motor Nano RevB firmware has not yet 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
    [camera.xacro, inertial_macros.xacro, lidar.xacro, robot.urdf.xacro, robot_core.xacro]
2026-08-25 Motor Nano RevB: reassign encoder and L298N pins
    Pin reassignment only -- no functional, behavioral, or protocol change.
    Encoders swap ports so each one routes to the header on its own side of
    the Nano instead of crossing the board: left moves PORTD (D2/D3) to PORTC
    (A4/A5, PCMSK1/PCINT1_vect), right moves PORTC (A4/A5) to PORTD (D6/D7,
    PCMSK2/PCINT2_vect, mask at bits 6,7). PCICR is unchanged -- PCIE1 and
    PCIE2 are still the two banks in use.
    L298N IN1-IN4 move to D3/D9/D10/D11, ascending on the D2-D12 header. This
    puts all four motor channels at a uniform 490 Hz with one Timer1 and one
    Timer2 channel per motor, so forward matches reverse and left matches
    right -- Kp/Kd/Ki/Ko are globals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
    [ROSArduinoBridge.ino, encoder_driver.h, encoder_driver.ino, motor_driver.h]
